kaiserShao/LEDPlay/灯带消消乐小程序头像 (1).jpg

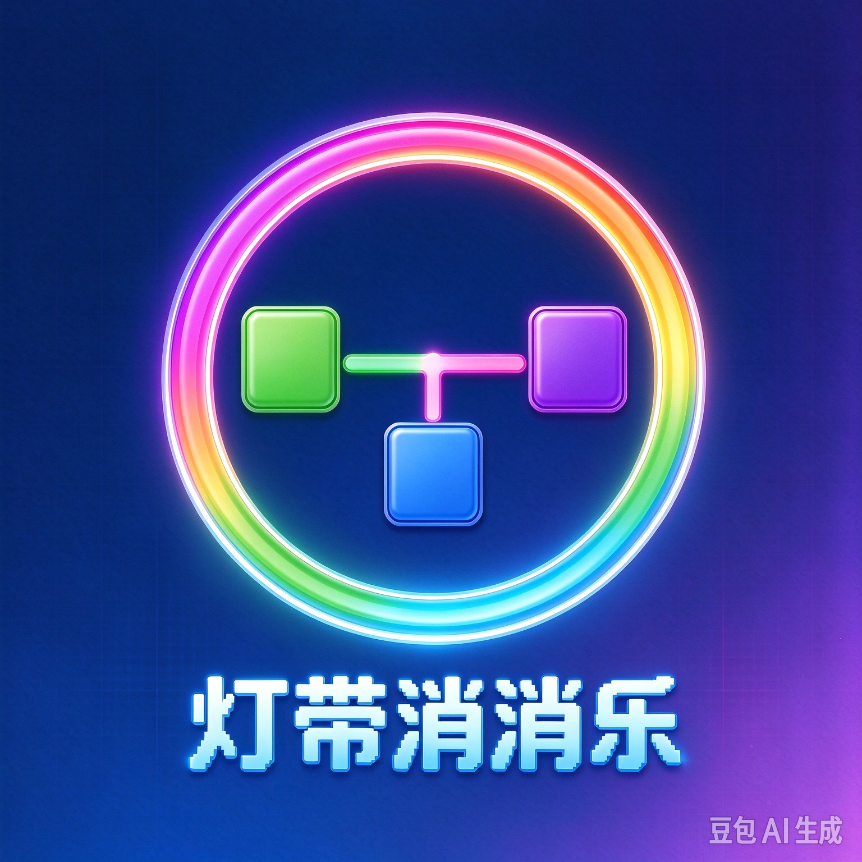
灯带消消乐小程序头像 (1).jpg
