kaiserShao/LEDPlay/Soft/Doc/WT2003_退役命令与自检备份.md

# WT2003 退役命令 / 自检 / 排查日志（备份文件）

> 精简固件时从代码里摘出来的东西，全部留档在这里。目的只有一个：
> 以后想找回某段逻辑、某个命令码、或某次排查的结论时，能在这里直接查到。
>
> 精简后的固件**只保留实测可用的这几条命令**（定义见 `Inc/bsp_config.h` 第 8 节、`Inc/drv_wt2003h.h`）：
>
> | 功能 | 命令码 | 帧（实测） | 接口 |
> |---|---|---|---|
> | 设置音量 | `AE` | `7E 04 AE <vol> <ck> EF` | `wt2003_set_volume(v)` |
> | 查询文件总数 | `C4` | `7E 03 C4 C7 EF` | `wt2003_query_count()` |
> | 按根目录索引播放 | `9D` | `7E 05 9D <高> <低> <ck> EF` | `wt2003_play_index(n)` |
> | 按文件名播放 | `9E` | `7E 07 9E <4 字符> <ck> EF` | `wt2003_play_name("0001")` |
> | 指定播放模式 | `AF` | `7E 04 AF <mode> <ck> EF` | `wt2003_set_mode(m)` |
> | 停止播放 | `AA` | `7E 03 AA AD EF` | `wt2003_stop()` |
> | **插播（叠加）** | `B1` | `7E 06 B1 <标示字> <高> <低> <ck> EF` | `wt2003_insert_index(n)` |
>
> 插播的**标示字**：`00` = FLASH（外挂 SPI Flash 片）/ `02` = U 盘（手册 4.1.2.14）；
> 例 外挂 Flash 曲目 3 → `7E 06 B1 00 00 03 BA EF`。
>
> 帧格式：`7E | 长度 | 命令 | 数据… | 校验码 | EF`，
> 长度 = `自身(1)+命令(1)+N(数据)+校验码(1)`，校验码 = 从"长度"字节起逐字节累加和。

## 1. 退役了什么（对照表）

| 退役项 | 原来在哪 | 留档位置（见文末对应标记段） |
|---|---|---|
| 38 步"语音链路体检"自检序列 + 探针回调 + 数码管显示步号 | `drv_wt2003h.c` / `main.c` | **D**、**E**、**C**；完整原件 `Doc/orig_20261005/` |
| Key 口 K1~K3（开漏低脉冲、语音编号→Key 绑定表） | `drv_wt2003h.c/.h` / `bsp_config.h` | **A**、**B**、**J** |
| 按文件名轮播（`A7`，每 4s 播下一个 + 自动查 C9/CB） | `drv_wt2003h.c` / `bsp_config.h` / `main.c` | **A**、**B**、**D**、**E** |
| 其它串口命令封装：`A0/A1/A6/A7/A8/AA/AB/AC/AD/AF/B0/B1/B6/B7/B8/D2/C0..CB` | `drv_wt2003h.c/.h` | **B**；完整原件 `Doc/orig_20261005/` |
| 主机调试命令：`WTRAW` / `WTPROBE` / `WTSTOP` / `WTST` / `VCHECK` / `VOUT` / `VQRY` / `VPLAY6` / `VPLAY0` / `VNAMEON` / `VNAMEOFF` / `VKEY` / `VSTOP` / `VPAUSE` / `VNEXT` / `VPREV` | `Src/app_cmd.c` / `Inc/app_cmd.h` | **F**、**G**、**K** |
| 收发帧的"人话解析"打印（`WTRXRAW/WTRX/WTRXINFO ...`） | `Src/main.c` | **D** |
| 旧 README 第 3.6 节 / 第 8 节（含 5 轮实测日志） | `README_DRIVERS.md` | **B** / **C** |
| 关机提示音（旧：`wt2003_talk(10)` 按编号播） | `Src/app_cmd.c` | **I** |
| 语音任务的"队列模式"（`wt2003_use_task/take_request/exec_request`） | `Src/app_task.c` / `drv_wt2003h.c` | **J** |

## 2. 旧驱动命令表（《WT2003H4-16S-A01》手册口径，**已废弃**）

> 这是精简前驱动里实现的整套命令（`drv_wt2003h.h` 的 `WT2003_CMD_xxx`）。
> 它们**不是**本模块真正吃的那套 —— 手头《WT2003HX》手册的可用命令见 `bsp_config.h` 第 8 节那 4 条。

| 命令 | 功能 | 数据 | 旧接口 |
|---|---|---|---|
| `A0` | 指定 **SPI Flash** 根目录索引播放 | 曲目号 2 字节（高/低） | `wt2003_play_flash(id)` |
| `A1` | 指定 **Flash** 按文件名播放 | 文件名 4 字节 ASCII | — |
| `A6` | 指定 **U 盘**根目录索引播放 | 曲目号 2 字节 | `wt2003_play_udisk(id)` |
| `A7` | 指定 **U 盘**按文件名播放 | 文件名 4 字节 ASCII | `wt2003_play_udisk_name("T002")` |
| `A8` | 指定 **U 盘文件夹内**文件索引播放 | 文件夹名 5 字节 + 索引 2 字节 | `wt2003_play_udisk_folder()` |
| `AA` | 播放 / 暂停 切换 | 无 | `wt2003_pause()` |
| `AB` | 停止 | 无 | `wt2003_stop()` |
| `AC` / `AD` | 下一曲 / 上一曲（跟当前盘符） | 无 | `wt2003_play_next/prev()` |
| `AE` | 音量控制 | 0~31 | `wt2003_set_volume(v)` |
| `AF` | 播放模式 | 00 单曲不循环 / 01 单曲 / 02 全部 / 03 随机 | `wt2003_set_mode(m)` |
| `B0` / `B1` | 组合播放 / 插播 | 标示字 + 索引（**`00`=FLASH（外挂 SPI Flash）** / `02`=U 盘，见现用手册 4.1.2.14） | `wt2003_play_combo()` / `wt2003_insert()` |
| `B6` | 音频输出方式 | 00 = SPK / 01 = DAC | `wt2003_set_output(o)` |
| `B7` | Flash 引脚加载 / 释放 | 00 释放 / 01 加载 | `wt2003_flash_pin(l)` |
| `B8` | 低功耗 | 1 字节 | `wt2003_low_power(m)` |
| `D2` | 切换当前工作盘符 | 00 = SPI-Flash / 02 = U 盘 | `wt2003_select_drive(d)` |
| `C0` | 查询软件版本 | 回 4 字节 | `wt2003_query_version()` |
| `C1` | 查询当前音量 | 回 1 字节 | `wt2003_query_volume()` |
| `C2` | 读取工作状态 | 回 1 字节：01 播放 / 02 停止 / 03 暂停 | `wt2003_query_status()` |
| `C3` | 查询 SPI Flash 文件总数 | 回 2 字节 | `wt2003_query_file_num()` |
| `C7` | 查询 U 盘文件总数 | 回 2 字节（实测只回 1 字节） | `wt2003_query_udisk_num()` |
| `C8` | 查询 U 盘指定文件夹内文件数 | 文件夹名 5 字节 → 回 2 字节 | `wt2003_query_ufolder_num()` |
| `C9` | 查询当前播放文件号 | 回 2 字节 | `wt2003_query_cur_file()` |
| `CA` | 查询外设连接状态 | 回 1 字节：bit3=PC / bit2=U 盘 / bit0=Flash | `wt2003_query_conn()` |
| `CB` | 查询当前歌曲名 | 回 8 字节 ASCII（实测只回 1 字节） | `wt2003_query_cur_name()` |

写命令返回码（旧手册）：`00` = OK / `01` = FAIL / `02` = EMP(无此文件)；
实测本模块对 `A6/D2/C7` 曾回手册未定义的 `0x05`，而且同一轮里喇叭确实出声 —— 所以**返回码不能当"有没有播"的判据**。

<!-- ===================== A : Doc/removed_bsp_sec8.txt ===================== -->

~~~~
<!-- ======== 涓嬮潰杩欐鏄粠 Inc\bsp_config.h 绗?234~336 琛岀Щ闄ょ殑鍘熸枃(鐣欐。) ======== -->
/*==============================================================================
 * 8. WT2003H4-16S 语音模块 (USART3: PB10=TX, PB11=RX ; K1~K3: PB0~PB2)
 *============================================================================*/
#define WT2003_UART                  USART3
#define WT2003_UART_CLK              RCC_APB1Periph_USART3
#define WT2003_UART_IRQn             USART3_IRQn
#define WT2003_TX_PORT               GPIOB
#define WT2003_TX_PIN                GPIO_Pin_10
#define WT2003_RX_PORT               GPIOB
#define WT2003_RX_PIN                GPIO_Pin_11
#define WT2003_BAUD                  9600U
#define WT2003_RX_BUF_SIZE           128U
#define WT2003_USE_CHECKSUM          1U       /* 1 = 帧尾前带累加和校验(WT2003HX 手册固定带),
                                                 0 = 不带 */
#define WT2003_LEN_COUNT_SELF        1U       /* 1 = 长度字节把[长度字节自己]也算进去
                                                 (WT2003HX 手册固定如此: 长度 = 1 + 命令 +
                                                 数据 + 校验码),
                                                 0 = 长度 = 命令 + 数据(+校验码) */
/* "按索引播放"走哪条命令 —— 只影响 wt2003_play_index()/wt2003_talk() 的串口通路:
    1 = A6 指定 U 盘根目录索引播放(《WT2003H4-16S-A01》手册 4.1.3.4;
        帧 7E 05 A6 <曲目高位> <曲目低位> <校验码> EF, 例 索引2 -> 7E 05 A6 00 02 AD EF);
    0 = A0 指定 SPI Flash 根目录索引播放(模块内置/外挂 SPI Flash 上的文件)。

    !!! 实测(模块固件 WTS251016-70-A01V4.01, 复现日志见 README 8.7 / 结论见 8.9):
        A0 索引 1        -> 回 02 = EMP(无此文件), 与本工程音频放在 U 盘相符;
        A6 索引 0/1/2/99 -> 一律回 0x05(手册未定义), 而且自检里 AC/AD(下一曲/上一曲)
                            真的出声、A6 一次都没出声 => 本模块的 A6 是"收下命令但不播"。
        => 要播指定语音请改走"按文件名播放"(A7):
           文件放 U 盘根目录、文件名固定 4 字符(如 T001.mp3 -> 数据 "T001"),
           驱动接口 wt2003_play_udisk_name("T001"), 配置见下面的 WT2003_NAME_CYCLE_*,
           串口命令 VNAME <n> / VNAMEON / VNAMEOFF。
    不想重烧就想两种都试: 串口发 VPLAY6 <idx>(A6) / VPLAY0 <idx>(A0) 对照听。 */
#define WT2003_PLAY_USE_UDISK        1U

/* Key 口(K1~K3)总开关:
   0 = 关闭(默认, 本项目的标准品 WT2003H4-16S 未开放 Key 口功能, 需芯片厂家定制):
         - wt2003_init() 不初始化 PB0~PB2, 也不建立"语音编号 1/2/3 -> K1/K2/K3"绑定;
         - wt2003_talk()/VOICE 一律走串口 A0 -> 绝不会出现"编号 1/2/3 静默无反应";
         - VKEY 直接回 ERR(提示已关闭)。
   1 = 打开(仅当模块已定制 Key 口功能时才用)。 */
#define WT2003_KEY_ENABLE            0U
#define WT2003_KEY_COUNT             3U       /* K1/K2/K3 */
#define WT2003_KEY_PORT              GPIOB
#define WT2003_KEY_GPIO_CLK          RCC_APB2Periph_GPIOB
#define WT2003_KEY1_PIN              GPIO_Pin_0
#define WT2003_KEY2_PIN              GPIO_Pin_1
#define WT2003_KEY3_PIN              GPIO_Pin_2
#define WT2003_KEY_PULSE_MS          100U     /* Key 口触发脉冲宽度 (拉低时间) */
#define WT2003_KEY_ROUTE_NUM         8U       /* ID -> Key 口 绑定表容量 */
#define WT2003_DEFAULT_VOLUME        31U      /* 上电默认音量 0~31 (手册: 上电默认最大 1F) */
#define WT2003_BOOT_VOICE            1U       /* 上电提示音编号(0 = 开机不播放) */
#define WT2003_BOOT_DELAY_MS         300U     /* 上电先等模块就绪(ms)再发首条命令 */
#define WT2003_PROBE_ON_BOOT         0U       /* 0 = 关闭(当前值): 上电不跑体检, 只按下面的
                                                 提示音/按文件名轮播播音频(见 8.1 节);
                                                 1 = 上电自动跑"语音链路体检"38 步
                                                 (AB 停止 -> D2 盘符=U 盘 -> B6 切 SPK ->
                                                  AE 音量 31 -> CA 查连接 / C7 查 U 盘文件数
                                                  (C3/C7 实测都只回 1 字节, 别拿来判介质) ->
                                                  C9/C2 基准 -> A6 播 U 盘索引 1 ->
                                                  AA 暂停后再 A6(判断"忙碌拒绝") ->
                                                  DAC/SPK 各播一次 -> AC/AD 换曲看 C9 ->
                                                  A6 播索引 2 扫 U 盘文件 -> AB 停止),
                                                 数码管显示步号, 日志见
                                                  WTTX/WTRX/WTRXINFO; 排查时置 1 即可;
                                                  实测结论(本模块 A6 收下命令但不出声、
                                                  AC/AD 才出声, 故改用 A7 按文件名播放)
                                                  见 README 8.9 */
#define WT2003_PROBE_INTERVAL_MS     1500U    /* 每步默认间隔(ms); 单步可用表里的 gap_ms 覆盖 */
#define WT2003_PROBE_ROUNDS          0U       /* 整个序列跑几轮(体检用 1 轮, 免得反复播) */

/*==============================================================================
 * 8.1 按文件名轮播(A7 播 U 盘根目录已知文件名) —— 排查"没声音"用, 也可当正式播放
 *     为什么用它: 实测本模块 A6(指定 U 盘索引播放)收到命令却不出声(回 0x05),
 *     而 A7 按文件名播放能出声(见 README 8.9)。
 *     前提: 音频文件放在 U 盘根目录, 且文件名**固定 4 个字符**(扩展名另算),
 *           例如 T001.mp3 / T002.mp3 ... -> 命令数据就是 "T001" / "T002"。
 *     开: WT2003_NAME_CYCLE_ON_BOOT = 1(上电立刻开始, 每 WT2003_NAME_CYCLE_MS 毫秒
 *         播下一个并循环; 串口打 "NAME n/N \"T00n\"", 数码管显示第几个)。
 *============================================================================*/
#define WT2003_NAME_CYCLE_ON_BOOT    1U       /* 1 = 上电开始按文件名轮播(当前排查用);
                                                 0 = 关闭(正式模式交给业务层点播) */
#define WT2003_NAME_CYCLE_MS         4000U    /* 每个文件播放/间隔时间(ms)。不要小于单个
                                                 音频时长, 否则下一首会把上一首切掉 */
#define WT2003_NAME_CYCLE_QUERY_MS   800U     /* 播后多少毫秒自动查一次 C9(当前曲目号) +
                                                 CB(当前曲目名), 用来确认"到底播没播";
                                                 必须 < WT2003_NAME_CYCLE_MS */
/* 要轮播的 4 字符文件名列表(按 U 盘里的真实名字改; 个数不限, 至少 1 个) */
#define WT2003_NAME_CYCLE_LIST        { "T001", "T002", "T003", "T004", "T005" }
#define WT2003_TX_TIMEOUT_MS         50U      /* 串口发送超时保护 */
#define WT2003_RX_FRAME_MAX          32U      /* 接收帧最大长度(实测 C0 版本查询的回帧较长,
                                                  16 字节不够会被整帧丢弃, 见 README 8.4) */
#define WT2003_RX_TRACE              1U       /* 0 = 关闭(默认, 正式模式静默, 不占串口带宽);
                                                 1 = 把模块返回帧实时打印到 ESP32 串口
                                                 (形如 "WTRX A0 00", 排查用; 判读见 README 第 8 节) */
#define WT2003_TX_TRACE              1U       /* 0 = 关闭(默认, 正式模式静默);
                                                 1 = 把主机"真正发出去"的每一帧原样打印到
                                                 ESP32 串口, 形如:
                                                     WTTX 7E 05 A6 00 01 AC EF   (发给模块: A6 播 U 盘索引 1)
                                                     WTRXRAW 7E 04 A6 00 AA EF   (模块回帧, 原始字节, 形如)
                                                 注: 按索引播放默认走 A6(播 U 盘, 见 WT2003_PLAY_USE_UDISK);
                                                     若选 A0(播 SPI Flash)则首帧是 7E 05 A0 00 01 A6 EF。
                                                 排查"到底发了几个字节/模块回什么"用, 不用挂
                                                 调试器也不用量逻辑分析仪; 排查时置 1 即可 */

~~~~

<!-- ===================== B : Doc/removed_readme_sec36.md ===================== -->

~~~~
<!-- ======== 涓嬮潰杩欐鏄粠 README_DRIVERS.md 绗?318~470 琛岀Щ闄ょ殑鍘熸枃(鐣欐。) ======== -->
### 3.6 语音模块 WT2003H4-16S（`drv_wt2003h`）—— Key 口与串口合并成一个方法
业务层只需要记一个入口：

```c
wt2003_talk(voice_id);        /* 自动选路: 查绑定表 → 命中走 Key 口(最快), 否则走串口 */
```

* 绑定关系：`wt2003_bind_key(voice_id, key_idx)`（0/1/2 → K1/K2/K3，`0xFF` 解除）。
  **默认关闭 Key 口**（`WT2003_KEY_ENABLE = 0`）：本项目的标准品 WT2003H4-16S 未开放
  Key 口功能（需芯片厂家定制），所以上电不再建立"1/2/3 → K1/K2/K3"绑定，
  `wt2003_talk()` 一律走串口 `A0`，不会出现"编号 1/2/3 静默无反应"；
  `VKEY` 也会直接回 `ERR VKEY unavailable`。改用定制模块时把该宏置 1 即可恢复原行为
  （宏位 1 时上电默认：编号 1/2/3 分别走 K1/K2/K3）。
* 想强制某条通路：`wt2003_talk_src(id, WT2003_SRC_UART)` 或 `WT2003_SRC_KEY`
  （Key 口关闭时 `SRC_KEY` 会自动退回 `SRC_UART`，保证"要播就能播"）。
* **串口协议（已对齐《WT2003HX 芯片》手册）**：

  帧格式：`7E | 长度 | 命令 | 数据… | 校验码 | EF`
  * 长度 = `1(长度字节自身) + 1(命令) + N(数据) + 1(校验码)`（**含自己**）；
  * 校验码 = 从"长度"字节起逐字节累加和（mod 256）。

  例（手册原例，本驱动发出的帧与之一致）：
  ```
  A0 SPI Flash 索引 1 :  7E 05 A0 00 01 A6 EF   (05+A0+00+01 = A6)
  A6 U 盘 索引 2      :  7E 05 A6 00 02 AD EF   (05+A6+00+02 = AD)
  AE 音量 = 31        :  7E 04 AE 1F D1 EF      (04+AE+1F     = D1)
  ```

  > ⚠ **介质决定命令码**：`A0` 只播 **SPI Flash** 上的文件，`A6` 只播 **U 盘**上的文件（手册 4.1.3.4）。
  > 命令用错时模块会回**非 0**（"指定曲目不存在"）而**不出声** —— 实测现象就是"命令回了、索引也在、就是没声音"。
  > 本项目音频放在 **U 盘**上，所以走 `A6`（`bsp_config.h` 的 `WT2003_PLAY_USE_UDISK = 1`）。

  命令码（`drv_wt2003h.h` 的 `WT2003_CMD_*`）：

  | 码 | 功能 | 数据 | 封装函数 |
  |---|---|---|---|
  | `A0` | 指定 **SPI Flash** 根目录索引播放 | 曲目号 2 字节(高/低) | `wt2003_play_flash(id)` |
  | `A1` | 指定 **Flash** 按文件名播放 | 文件名 4 字节 ASCII | —（手册 4.1.3.3） |
  | `A6` | 指定 **U 盘**根目录索引播放 | 曲目号 2 字节(高/低) | `wt2003_play_udisk(id)` |
  | `A7` | 指定 **U 盘**按文件名播放 | 文件名 4 字节 ASCII | `wt2003_play_udisk_name("T002")` |
  | `A8` | 指定 **U 盘文件夹内**文件索引播放 | 文件夹名 5 字节 + 索引 2 字节 | `wt2003_play_udisk_folder("MUSIC", n)` |
  | `AA` | 播放暂停（播放 <-> 暂停 切换） | 无 | `wt2003_pause()` |
  | `AB` | 停止 | 无 | `wt2003_stop()` |
  | `AC` | 下一曲（跟当前工作盘符） | 无 | `wt2003_play_next()` |
  | `AD` | 上一曲（跟当前工作盘符） | 无 | `wt2003_play_prev()` |
  | `AE` | 音量控制 | 0~31 | `wt2003_set_volume(v)` |
  | `AF` | 指定播放模式 | `00` 单曲不循环 / `01` 单曲循环 / `02` 全部循环 / `03` 随机 | `wt2003_set_mode(m)` |
  | `B1` | 插播 | 标示字（**`00`=FLASH（外挂 SPI Flash）** / `02`=U 盘，手册 4.1.2.14）+ 索引 2 字节 | `wt2003_insert(buf, len)` |
  | `B6` | 音频输出方式 | `00`=SPK / `01`=DAC（手册示例：**无返回码**） | `wt2003_set_output(...)` |
  | `B7` | Flash 引脚加载 / 释放 | `00`=释放 / `01`=加载 | `wt2003_flash_pin(load)` |
  | `D2` | 切换当前工作盘符 | `00`=SPI-Flash / `02`=U 盘 | `wt2003_select_drive(WT2003_DRIVE_UDISK)` |
  | `C0` | 查询软件版本（手册未列出，实测有应答） | — | `wt2003_query_version()` |
  | `C1` | 查询当前设置音量 | — | `wt2003_query_volume()` |
  | `C2` | 读取当前工作状态（`01` 播放 / `02` 停止 / `03` 暂停） | — | `wt2003_query_status()` |
  | `C3` | 查询 **SPI-Flash** 内音乐文件总数 | — | `wt2003_query_file_num()` |
  | `C7` | 查询 **U 盘**内音乐文件总数 ← **本项目用这条** | — | `wt2003_query_udisk_num()` |
  | `C8` | 查询 U 盘指定文件夹内文件总数（回 `00 00` = 无此文件夹） | 文件夹名 5 字节 | `wt2003_query_ufolder_num("MUSIC")` |
  | `C9` | 查询当前播放文件曲目 | — | `wt2003_query_cur_file()` |
  | `CA` | 查询当前外设连接状态（bit3=PC / bit2=U 盘 / bit0=SPI-Flash，1=存在） | — | `wt2003_query_conn()` |
  | `CB` | 查询当前播放歌曲名（8 字节 ASCII，不足补 `20`） | — | `wt2003_query_cur_name()` |
  | `B0` / `B8` | 组合播放 / 低功耗（本版手册未列出，保留兼容） | — | `wt2003_play_combo` / `wt2003_low_power` |

  > **介质千万别搞错**：`A0/A1` 与 `C3` 是 **SPI-Flash**；`A6/A7/A8` 与 `C7/C8` 是 **U 盘**。
  > 本项目音频在 U 盘 → 播放用 `A6`（或 `A7/A8`），"还有几个文件"看 `C7`，
  > "模块认到盘没有"看 `CA` 的 bit2；`C3` 恒为 0 属正常（它查的是 SPI-Flash）。

  > **写命令的返回码**（手册 4.1.3.1"写操作指令返回码格式"）：执行完每条写命令，模块回
  > `<命令码> <1 字节操作码>`：`00 = OK` / `01 = FAIL（出错，不执行）` / `02 = EMP（无此文件）`。
  > ★ 但本模块（`WT2003H4-16S`，固件 `WTS251016-70-A01V4.01`）实测 `D2` / `A6` / `C7`
  > 都回 **`0x05`** —— 手册里没有这个值，而同一轮音频**照样播出来了**：
  > 所以 **`0x05` 绝不能当"没播"**，`A6`/`D2` 回非 0 不等于失败，`README 8.7` 有完整判读。
  > 查询命令（`C1/C2/C3/C7/C8/C9/CA/CB`）回的是**数据**、不是返回码，别套这张表。

  > 音量共 **32 级（0~31）**：0 = 静音、31 = 最大；此命令**掉电记忆**，模块上电默认最大（`1F`）。
  > 查询命令只发帧，应答由 `wt2003_set_frame_handler()` 回调上报（远程命令 `VQRY` 可触发，见第 4 节）。
  > **按索引播放**的封装函数 `wt2003_play_index(id)` = `wt2003_talk()` 走串口那条路，它用哪条命令
  > （`A6` 播 U 盘 / `A0` 播 SPI Flash）由 `bsp_config.h` 的 `WT2003_PLAY_USE_UDISK` 选（默认 `1` = `A6`）。
  > **⚠ 但本模块实测 `A6` 收下命令却不出声（第五轮定论，见 8.9）**：要播指定语音请改走
  > `A7` 按文件名播放 —— `wt2003_play_udisk_name("T001")` / 远程 `VNAME <n>`（文件名 4 字符、放 U 盘根目录）。

* **按文件名轮播（`WT2003_NAME_CYCLE_ON_BOOT`，当前为 **1** = 开）**：上电用 `A7` 每
  `WT2003_NAME_CYCLE_MS`（`4000` ms = **4 秒**）播 `WT2003_NAME_CYCLE_LIST` 里的下一个文件名并循环，
  播后自动查一次 `C9`/`CB`（确认模块到底播的是哪一首）；数码管显示第几个，串口打 `NAME n/N "T00n"`。
  **这是本模块唯一能播指定语音的路**（`A6` 无效，见 8.9）；不用时置回 `0`。
  远程命令：`VNAME`（列名字表）/ `VNAME <n>`（立刻播第 n 个）/ `VNAMEON` / `VNAMEOFF`。
* **语音链路自检序列（`WT2003_PROBE_ON_BOOT`，当前为 **0** = 关闭 —— 第五轮结论已拿到（见 8.9），
  正式模式走"按文件名轮播"或开机提示音 `WT2003_BOOT_VOICE`；要复现时再置 1）**：置 1 时上电后按
  各步自己的间隔自动走完 **38 步**，**数码管显示第几步**（`0001`~`0038`），
  同时从 ESP32 串口打一行 `PROBE n/38 <说明> rx=..`；结束时数码管显示模块**回帧计数**低 4 位
  （`0000` = 模块一句都没回），串口还会打一行 `PROBE DONE rx=.. cmd=..`。
  也可随时用远程命令 `WTPROBE n` 单独发第 n 步、`WTSTOP` 停止、`WTST` 看状态。
  排查完把 `WT2003_PROBE_ON_BOOT` 改回 **0**（仓库默认就是 0；正式模式只播开机提示音）。

  | 步骤 | 实际发出的东西 | 说明 |
  |---|---|---|
  | 1 | `AB` | 停止播放，清掉"卡在播放/忙"的状态 |
  | 2 | `D2 02` | 切换当前工作盘符 = **U 盘**（让 `AC/AD`、循环这些"跟着当前盘走"的命令也作用在 U 盘） |
  | 3 | `B6 00` | 输出 = `SPK`（**喇叭必须接 `SPK+` 与 `SPK-` 两端**，一端接 GND 则永远无声） |
  | 4 | `AE 1F` | 音量 = 31（排除"音量被存成 0 = 静音"） |
  | 5~7 | `C1` / `CA` / `C7` | 播放前基准：音量 / **外设连接（`UDISK` 位必须是 1）** / **U 盘文件数（`00 00` = 模块看不到文件）** |
  | 8~9 | `C9` / `C2` | 当前文件号 / 工作状态基准（打印后面带 `UNCHANGED` / `CHANGED!`） |
  | 10 | `A6 00 01`（U 盘索引 1） | 第 1 次试播 —— **听**有没有声 |
  | 11~12 | `C9` / `C2` | 当前文件号 / 状态**有没有跟着变** |
  | 13~14 | `AA` / `C2` | 把"自认为在播"的东西**暂停掉**，再看状态 |
  | 15 | `A6 00 01` 再来一次 | 和无声音时的旧结论对比：**只有回 `00` 才算"忙碌拒绝"**；本固件 `A6` 回 `05` 时照样出声（见 8.7）—— **听** |
  | 16~17 | `C9` / `C2` | |
  | 18 | `AB` 停止 | |
  | 19~20 | `B6 01` → `A6 00 01` | 换到 `DAC` 通路再试播（喇叭若实际走 DAC / 功放，这一步后有声）—— **听** |
  | 21~22 | `AA` → `B6 00` | 切回 `SPK` 通路 |
  | 23~24 | `A6 00 01` / `C2` | 在 `SPK` 通路再试播 —— **听** |
  | 25~28 | `AC` + `C9`、`AD` + `C9` | 换曲引擎：`cur_file` 会不会在 1 与 2 之间跳 |
  | 29 | `A6 00 02` | 扫 U 盘文件索引 2（回 `00` = 该索引有文件可播，`02` = 无此索引）—— **听** |
  | 30 | `AB` 停止 | 收尾 |
  | 31 | `C3` | 文件数查询 —— 手册写它是 **SPI-Flash** 口径，但**实测本模块 `C3 == C7` 同为 1 字节（都回 `05`）**，所以它**不能**用来判介质（判介质见 8.9） |
  | 32 | `A6 00 63` | 发一个**必定不存在**的索引（99）：应回 `02 = EMP（无此文件）`——用它验证"返回码表在不在本固件生效" |
  | 33 | `C2` | 那条"失败"的 `A6` 有没有影响状态 |
  | 34 | `A6 00 00` | 索引 **0**：有些固件的索引从 0 开始（手册 4.1.4.5 示例写"索引 `0001` = 第 2 首"）—— **听** |
  | 35 | `C2` | 短间隔再查一次：有没有变成 `01 = 播放` |
  | 36 | `A0 00 01` | SPI-Flash 口径播索引 1（Flash 里真没文件时应回 `02`，交叉验证 31） |
  | 37 | `C9` | 当前文件号 |
  | 38 | `C2` | 收尾状态 |

  > 实测例（第四轮，2026-07，38 步序列，完整日志与判读见 **8.7**）：`D2 → 05`、`B6 → 00`、`AE → 00`、
  > `C1 = 1F`（音量满）、`CA = 00`（`UDISK` 位 = 0，可 `C7` 却回 `05` = 5 个文件）、
  > `C9 = 0001 → 0002 → 0001`（`AC`/`AD` 真的把当前曲目推动了）、`C2 = 02`（全程 `STOPPED`）、
  > `A6` 试播回 `0x05` —— **现场反馈这几步里喇叭确实出声了**。
  > ⇒ 本固件的 `0x05` **不是"失败"**（手册 4.1.3.1 只定义了 `00 / 01 / 02`），
  > 判断"到底播没播"必须**以耳朵为准**，不能只看返回码。
  > 更早的实测例（8.4~8.6，旧序列）：`C3 = 05`、`C9 = 0001`、`C2 = 02`、`A0` 索引 0 回 `01`、
  > 索引 1~4 回 `02`、`C0 = WTS251016-70-A01V4.01`，全程无声。

  > → "忙"和"没文件"都被排除，嫌疑落在「模块播不了这些文件（格式 / 文件系统）」或「曲目索引没建立」，
  > 靠第 15 / 17 步（`AA` / `AC`，绕过索引）来区分。
  > Key 口：本项目标准品 WT2003H4-16S 没开放 Key 口功能（需厂家定制，`WT2003_KEY_ENABLE = 0`），
  > 自检序列里的 Key 步骤已移除（`VKEY` 会直接回 `ERR VKEY unavailable`）；换成定制模块后
  > 用 `VKEY 0/1/2` 单独触发即可。
  > 索引：`A0`/`A6` 的曲目号是 2 字节（高/低），模块内文件索引通常按扫描顺序，不一定等于文件名数字。
  > 介质：本项目用 **U 盘**（`A6`，`WT2003_PLAY_USE_UDISK = 1`）；用错命令（拿 `A0` 播 U 盘）会回非 0 且不出声。
* Key 口：开漏输出 + 低脉冲（脉宽 = `WT2003_KEY_PULSE_MS`，由 `wt2003_process()` 到点释放，**不阻塞业务**）。
* 其他串口命令：`wt2003_play_index / play_next / play_prev / pause / stop / set_volume /
  set_mode / play_combo / insert / set_output / low_power / query_*`，
  也可用 `wt2003_send_cmd(cmd, data, len)` 或 `wt2003_send_raw(frame, len)` 发手册上的任意帧。
* 模块返回帧由 `wt2003_process()` 解析，结果通过 `wt2003_set_frame_handler()` 回调上报
  （驱动已剥掉命令码与校验码，回调拿到的是纯数据区）。

**⚠ 与实物核对清单（都集中在 `bsp_config.h` / `drv_wt2003h.h`）：**

1. **命令码**：`WT2003_CMD_*`（已按 WT2003HX 手册填好：`A0/A6/AA/AB/AC/AD/AE/…`）；固件不同时只改这一处。
   **按索引播放用哪条命令**由 `bsp_config.h` 的 `WT2003_PLAY_USE_UDISK` 决定（**U 盘 = `A6`**：置 `1`；SPI Flash = `A0`：置 `0`）。
2. **帧格式**：`WT2003_USE_CHECKSUM = 1`、`WT2003_LEN_COUNT_SELF = 1`（手册固定如此，勿改）。
3. **波特率**：`WT2003_BAUD`（取值见 `bsp_config.h` 第 8 节）。
4. **音频输出方式**：喇叭接模块内部功放（SPK）却无声时，用 `VOUT 0` 或上电发一次 `B6 00` 切回 SPK。

~~~~

<!-- ===================== C : Doc/removed_readme_sec8.md ===================== -->

~~~~
<!-- ======== 涓嬮潰杩欐鏄粠 README_DRIVERS.md 绗?765~1185 琛岀Щ闄ょ殑鍘熸枃(鐣欐。) ======== -->
## 8. WT2003 语音排查（协议已按手册对齐）

> **⚠ 先看这两条（第五轮定论，完整判读见 8.9）**：
> 1. `A0`（SPI Flash 索引）会被模块当"指定曲目不存在"拒绝（回 `02`）—— 本工程音频在 **U 盘**上，
>    用 `A0` 自然全程无声；8.4~8.6 里"模块播不了文件 / 曲目索引没建立"的结论是**在命令用错的前提下**得到的。
> 2. **但 `A6`（指定 U 盘根目录索引播放）在本模块上也不出声**：它收下命令、回一个固定字节 `05`，
>    却从不播放（索引 1 / 2 / 99 / 0 全试过，`cur_file` 从不因它变化）；而 `AC` / `AD`（下一曲 / 上一曲）
>    从停止态都能出声 ⇒ 播放引擎与音频链路正常，**只有"按索引指定曲目"这条路不通**。
>    ⇒ 正式播指定语音改用 **`A7` 按文件名播放**（文件名固定 4 字符、放 U 盘根目录）：
>    `wt2003_play_udisk_name("T001")` / 远程 `VNAME <n>`，配置与判读见 8.9.2。
> 现场对照：`VNAME 1` 应有声；`VPLAY6 1`（A6）/ `VPLAY0 1`（A0）都不出声。

### 8.1 看收发帧（`WT2003_TX_TRACE` / `WT2003_RX_TRACE`，仓库默认都是 0 = 关闭）
`Inc/bsp_config.h` 里这两个开关打开时，`main.c` 会把**每一次收/发**都从
**ESP32 串口（USART1, 115200）** 打一行 ASCII：

```
WTTX 7E 05 A0 00 01 A6 EF    主机真正发出去的原始字节(每次发帧都打)
WTRXRAW 7E 04 A0 00 A4 EF    模块回帧的原始字节(含 7E/长度/校验码/EF)
WTRX A0 00                   同一帧解析后的结果: 命令码 + 数据区
WTRX C1 1F                   命令码 0xC1(查询音量), 数据区 1F(=音量 31)
WTRXINFO A0(SPI-Flash) ret=0x02 = EMP (no such file)        解析成人话(见 8.4 / 8.7)
WTRXINFO A6(U-disk) ret=0x05 = 0x05 (undocumented; ... audio still plays)   ★ 非 0 ≠ 没播!
WTRXINFO flash_files=5 (SPI-Flash, 1-byte reply; compare with C7)  C3 的解析(实测只回 1 字节)
WTRXINFO udisk_files=5 (U-disk, 1-byte reply) [ok: ...]      C7 的解析 <== 本工程看这条
WTRXINFO conn=0x00 PC=0 UDISK=0 FLASH=0                      CA 的解析(要连 C7 一起看)
WTRXINFO cur_file=1 / volume=31 / status=0x02 [STOPPED]      C9 / C1 / C2 的解析
WTRXINFO ver=........ (len=26, hex 见上面的 WTRX 行)          C0 的解析(长回帧, 见 8.4)
WTRXBAD 7E 1A C0 ...         结构不对的回帧(帧尾不是 EF / 帧长超缓冲)也原样打出来
```

* **判据 0（先看有没有 WTRXBAD）**：`WTRXBAD` 行 = 模块回的字节**没能按手册格式解析**，
  例如长度字节口径不同、或整帧比 `WT2003_RX_FRAME_MAX` 还长。以前这类字节会被驱动**静默丢掉**，
  表现为"`WTST` 的 `rx=` 一直在涨，却一行 `WTRXRAW` 都没有"——看到 `WTRXBAD` 就以它为准。

* **判据 1（长度字节）**：手册 5.1.2.2 的原例是
  `发→ 7E 05 A0 00 01 A6 EF` / `收← 7E 04 A0 00 A4 EF`。
  主机发 `A0` **必然带 2 字节曲目号**（长度 05 = 1 自身 + 1 命令 + 2 数据 + 1 校验码）；
  模块回帧的长度只有 **04**（1 个数据字节）。所以看到 `7E 04 A0 xx ...` 是**模块的回帧**，
  不要当成主机发出去的帧。
* **判据 2（看谁在写缓冲）**：调试器里的 `s_rx_buf` 是驱动的**接收**环形缓冲
  （`drv_wt2003h.c`，`WT2003_RX_BUF_SIZE` = 128 字节；ESP32 的那个才是 512 字节），
  它是"模块 → MCU"的字节，还带上一帧的残留。想要"这一帧的干净原貌"用
  `wt2003_last_rx_raw(&len)`（`WTRXRAW` 行就是它），想要"主机发了什么"看 `WTTX` 行。
* 驱动按手册格式 `7E 长度 命令 数据 校验码 EF` 解析，`WTRX` **已剥掉命令码与校验码**，
  打印的就是纯数据区。
* 没有输出 = 模块没有回话，这就是最直接的判据；也可以用远程命令 `WTST` 看累计 `rx=` 字节数。
* 关闭：把两个开关都改成 0（**仓库默认就是 0**，正式固件免得占串口带宽；置 1 才有下面这些行）。

> 想确认"A6 到底发了几个字节"：把 `WT2003_TX_TRACE` 置 1 重烧，敲 `WTRAW 7E05A60001ACEF`
> 或跑 `WTPROBE 8`（自检表第 8 步 = `A6` 播 U 盘索引 1），串口应打出
> `WTTX 7E 05 A6 00 01 AC EF` —— 7 字节、长度 05。

### 8.2 由现象定位（按顺序做）

| 现象 | 结论 / 下一步 |
|---|---|
| `WTST` 的 `rx=0`（模块一句都没回） | 查 TX 线（PB10 → 模块 RXD）、**共地**、`WT2003_BAUD` = 9600、模块是否处于串口控制模式 |
| `rx` 在涨但没有 `WTRXRAW`，只有 `WTRXBAD` | 模块回帧**格式与手册不一致**（长度字节口径 / 帧长超 `WT2003_RX_FRAME_MAX`）→ 按 `WTRXBAD` 的原始字节对着手册核，别怀疑接线 |
| 自检第 1 步（`AB` 停止）之后、第 8 步（`A6`）之后才出声 | 模块此前卡在"播放/忙"（查询 `C2` = `02`）→ 正式固件上电应先 `VSTOP` 再播提示音 |
| 第 2 步（`B6 01` DAC）无声、第 3 步（`B6 00` SPK）才出声 | 模块此前处于 DAC 输出 → 用 `VOUT 0` 固定为 SPK，或核对喇叭接法 |
| `A6` 全回 `05` 且**全程无声**，但 **`AC` / `AD`（下一曲 / 上一曲）出声** | **第五轮定论（见 8.9）**：本模块 `A6` 收下命令但不播 → 改用 `A7` 按文件名播放（`VNAME <n>` / `wt2003_play_udisk_name("T001")`），不必再去折腾索引排序或厂商上位机 |
| `A6` 回 `01`（索引 0）、`A6` 回 `02`（索引 1~5）都没声，`AA`/`AC` 也没声 | 模块**播放不了它里面的文件**（不是索引问题）：文件格式/采样率/码率不被支持、或文件系统被半途拔线写坏 → 用厂商上位机＋标准 MP3 重灌（见 8.4） |
| `A6` 回 `00`（`ret=0x00`）但仍无声 | 播放已被接受 → 完全转音频侧：音量（`C1`）、输出方式（`B6` = SPK）、功放供电/使能脚、喇叭是否接在 `SPK` 13/14 脚、共地 |
| 查询回来 `files=0`（`C3` 回 `00`） | 模块**没认到文件**：格式 / 命名 / 目录不符合模块要求，用厂商上位机重新灌 |
| `WTRX A6 05`（或 `D2 05`） | 手册 4.1.3.1 只定义 `00/01/02`，`05` 是本固件私有的固定应答，**既不代表成功也不代表失败**；但第五轮实测 `A6` 回 `05` 时**确实一声都没有**（见 8.9）→ 别再用 `A6`，改 `VNAME <n>`（`A7`） |
| `WTRX A6 xx` 且 `xx` = `01` / `02` | 手册口径的**真失败**（`01` = 出错不执行 / `02` = 无此文件）：`VSTOP` → `VCHECK`（文件数 / 音量 / 当前文件）→ `VPLAY 1/5…` 扫索引，详见 8.4 |
| 索引对不上 | `VQRY FILES` / `VCHECK` 看文件总数（`udisk_files=`）、`C9` 看当前文件；**播指定语音用 `VNAME <n>`**（`A7` 按文件名，不受索引顺序影响），别用 `A6`（见 8.9） |

> `WTRX C1 xx` 的 `xx` 就是模块当前音量；`WTRX C2 xx` 是工作状态（实测 `02`）；
> `WTRX C3 xx` 是文件总数 —— **实测模块只回 1 字节**（`7E 04 C3 05 CC EF` = 5 个文件），
> 驱动对 1 字节和 2 字节两种回法都做了兼容解析。

### 8.3 免重烧试任意帧（`WTRAW`）
`wt2003_send_raw()` 挂在远程命令上，**不改代码、不重烧**就能把手册里的任意帧发给模块：

```
WTRAW 7E05A60001ACEF          # A6 播 U 盘索引 1（本工程音频在 U 盘）
WTRAW 7E 05 A6 00 01 AC EF    # 空格分隔；也接受 0x7E / 逗号 / 冒号
WTRAW 7E05A00001A6EF          # A0 播 SPI Flash 索引 1（对照用）
WTRAW 7E04AE1FD1EF            # AE 音量 = 31
WTRAW 7E04B600BAEF            # B6 切 SPK
```

* 应答 `OK WTRAW 7E05A00001A6EF (7 bytes)` = 已发出；`ERR WTRAW HEX ...` = 十六进制没解析出来；
* 模块回帧打印成 `WTRX ...`；`WTST` 可看 `rx=` / `cmd=` 计数。

### 8.4 实测案例：日志全对、有回帧，但一点声音都没有

现场日志（ESP32 串口 115200，`WT2003_TX_TRACE` / `WT2003_RX_TRACE` = 1）：

```
READY LEDAnipop fw=1.0 led=120
WTTX 7E 04 AE 1F D1 EF        ① 上电设音量 31（手册 5.1.2.7 原例, 4 字节）
WTTX 7E 05 A0 00 01 A6 EF     ② 上电播索引 1（手册 5.1.2.2 原例, 7 字节, 长度 05）
WTRXRAW 7E 04 AE 00 B2 EF     ③ AE 回帧: 长度 04, 数据 00
WTRXRAW 7E 04 A0 02 A6 EF     ④ A0 回帧: 长度 04, **数据 02**
WTRX A0 02
WTRXINFO A0 ret=0x02 (NOT started: send AB first, then check file/index)
```

再敲一次 `VCHECK`（把 C0/C1/C2/C3/C9 全查一遍），现场回帧：

```
WTTX 7E 03 C1 C4 EF
WTTX 7E 03 C2 C5 EF
WTTX 7E 03 C3 C6 EF
WTTX 7E 03 C9 CC EF
WTRXRAW 7E 04 C1 1F E4 EF      C1 回帧: 数据 1F = **音量已经是 31（最大）**
WTRXINFO volume=31 (0=silent, 31=max)
WTRXRAW 7E 04 C2 02 C8 EF      C2 回帧: 数据 02 = **不是空闲状态**
WTRXINFO status=0x02 (non-idle; 0x02 seen while A0 also replies 02)
WTRXRAW 7E 04 C3 05 CC EF      C3 回帧: 长度 04 → **只有 1 个数据字节**，05 = **模块认到 5 个文件**
WTRXINFO files=5 (1-byte reply; 0 = module sees no files)
WTRXRAW 7E 05 C9 00 01 CF EF   C9 回帧: 长度 05（2 字节数据）0001 = 当前文件 1
WTRXINFO cur_file=1
```

判读（这套日志已经能排除一半的怀疑方向）：

* ①② 证明**主机发送侧完全正确**：`A0` 就是 2 字节索引、长度 05，与手册逐字节一致；
  而且模块每次都有回帧，说明波特率 / 接线 / 共地也没问题。
* ③④ 是**模块的回帧**（长度 04，不是主机帧；主机帧长度必然是 05）。
* ④ 的数据字节是模块的**处理结果**：手册示例里这里是 `00`，实测是 `02`
  → **模块没有真正开始播放**，"没声音"的原因在模块侧（文件 / 索引），不在 MCU 侧。
* ③ `AE` 的回帧数据是 `00`，表示音量命令被接受（返回值口径见手册 5.1.2.7）。
  **它不等于当前音量** —— 想知道真实音量必须用 `C1` 查询（`VCHECK` 会打 `volume=`）：
  音量是**掉电记忆**的，若模块存的是 0（静音），播放"成功"也一样听不见。
* 文件是**用 USB 把模块当 U 盘拷进去**的（模块里确实有音频）→ 那么 `A0` 回 `02` 基本只剩
  **文件规则 / 索引号**问题：模块内的索引顺序由它扫描文件系统的顺序决定，**不一定等于文件名里的数字**。
  用 `VCHECK` 看 `files=`（模块认到几个文件），再用 `VPLAY 0/1/2…` 找到回 `ret=0x00` 的那个索引；
  若 `files=0`，则是文件**格式 / 命名 / 目录**不被模块认（对照手册的命名与格式要求重灌）。

`VCHECK` 之后方向就基本唯一了：

* 音量 = `1F`（31，最大）、文件数 = `05` → **"静音"和"没文件"这两个最常见的怀疑都被排除**。
* `C2`（状态）回的 `02` 与 `A0` 被拒时回的 `02` 是**同一个值** → 当时推测模块**一直认为自己"忙于
  播放/未就绪"**（例如上一次播放被中途打断后没清理），于是对任何新的 `A0` 都回 `02`。
  这种状态下继续扫索引没有意义，必须**先发 `AB` 停止清状态**再发 `A0`。
* 自检序列已按这个顺序改成（上电自动跑）：
  **1 = `AB` 停止 → 2~3 = `B6` 切 SPK → 4 = `AE` 音量 31 → 5~9 = `C1/C3/C9/C0/C2` 查询 →
  10~14 = 播放索引 0~4**；哪一步出声、哪一条回 `ret=0x00`，看日志就能定位。
  > 最终定位：本节及 8.5/8.6 里的 `A0` 是被"命令码用错"拖累的（`A0` 只播 SPI Flash）；本项目音频在 U 盘，
  > 现自检里的试播已全部改为 **`A6`（播 U 盘）**，见第 3.6 节。
  > 这一版跑完后（见 8.5）发现 `AB` 其实**回 `00` 被接受了**、而 `A0` 依旧全被拒，
  > 所以"忙于播放"被排除，序列随即改成 **20 步**（去掉 `C0` 的位置、加上 `AA`/`AC` 绕过索引）；
  > 20 步跑完的现场数据与判读见 **8.6**，序列再升级为 **30 步**；第四轮又加了
  > "返回码取证"（`C3` 对比、不存在的索引、索引 0、`A0`）成为 **38 步**，见 8.7。
* 如果 `AB` 之后 `A0` 仍回 `02`，则是**模块里的"曲目索引"没建立**：`C3` 只是数了文件系统里的文件，
  不代表模块已经把它们排好成"曲目 1/2/3…"。处理办法（按代价从小到大）：
  1. 用厂商上位机把这个 U 盘/模块里的音频**重新排序（生成/更新曲目索引）**；
  2. 或按手册要求把文件重命名（如 `00001.mp3`、`00002.mp3` …）后**重新拷一次**，再上电复位；
  3. 或直接用厂商上位机点播一首，确认模块自己能出声（这一步能彻底排除功放/喇叭/供电）。

按顺序做（全部用远程命令，不需要重烧）：

```
VSTOP          → 先停一次: 清"忙于播放"状态（实测 AB 回 00 = 被接受）
VCHECK         → 一条命令把 C0/C1/C2/C3/C9 全查一遍: 看 WTRXRAW(原始) / WTRX / WTRXINFO
                 （重点: files=? volume=? cur_file=?）
VPLAY 1        → 逐个索引扫（1/5/0…），看哪一条回帧变成 ret=0x00 并且出声
VOUT 0         → 强制切回 SPK 输出（喇叭接模块 SPK 脚 / 内部功放时用）
VOL 31         → 音量设到最大（掉电记忆，可能是 0 = 静音）
WTRAW 7E03AAADEF → AA 播放当前曲目（绕开索引: 出声说明引擎好、是索引问题）
WTRAW 7E03ACAFEF → AC 下一曲（同上）
```

* **模块自己能出声的独立验证**（不依赖本固件）：用厂商上位机让模块播一首
  （自检序列里已无 Key 步骤 —— 本项目标准品 Key 口没引出功能，需厂家定制，`VKEY` 会回 `ERR`）。
  → 能出声说明模块 / 功放 / 喇叭 / 供电都好，问题只在"文件 + 索引号"。
* **模块自己也不出声** → 直接查音频侧：文件格式/采样率是否被模块支持、音量是否为 0、
  喇叭是否接在 `SPK`（13/14 脚）、共地。

### 8.5 第二轮实测（20 步自检：把"索引问题"和"文件问题"分开）

第一轮（14 步）跑完的现场日志（片段）：

```
WTTX 7E 03 AB AE EF
PROBE 1/14 AB stop play (clear stuck busy state) rx=8
WTRXRAW 7E 04 AB 00 AF EF    WTRX AB 00        ← **AB 被接受**(数据 00), "卡在忙"的假设不成立
WTRXRAW 7E 04 AE 00 B2 EF                      ← AE 音量命令被接受
WTRXRAW 7E 04 C1 1F E4 EF    volume=31         ← 音量已是最大
WTRXRAW 7E 04 C3 05 CC EF    files=5           ← 模块认到 5 个文件
WTRXRAW 7E 05 C9 00 01 CF EF cur_file=1
WTTX 7E 03 C0 C3 EF          PROBE 8/14 ... rx=51
WTTX 7E 03 C2 C5 EF          PROBE 9/14 ... rx=77   ← **rx 涨了 26 字节, 却一行 WTRXRAW 都没有**
WTRXRAW 7E 04 C2 02 C8 EF    status=0x02
WTRXRAW 7E 04 A0 01 A5 EF    A0 ret=0x01        ← 索引 0: 回 01
WTRXRAW 7E 04 A0 02 A6 EF    A0 ret=0x02        ← 索引 1~4: 回 02
```

三条新结论：

1. `AB` 回 `AB 00` = 停止命令**被接受** → "模块卡在播放/忙"这个假设**基本不成立**（真被卡住的话，
   `AB` 之后就该能播了；可后面 5 个 `A0` 依然全被拒）。
2. **`A0` 索引 0 回 `01`、索引 1~4 回 `02`** —— 两个**不同**的返回码，说明模块区分了两种情况
   （"索引/参数无效" vs "索引有效但播不起来"）。至少可以确定：模块**认得这些索引**，
   只是**没能真的播放出来** → 嫌疑从"索引号填错"转向"模块播放不了这些文件（格式 / 文件系统）"。
3. `C0`（版本）那 26 字节"收了却没解析"：`WT2003_RX_FRAME_MAX` 原来是 16，而 C0 的回帧比它长，
   整帧被驱动**静默丢掉**（`rx` 一直涨、`WTRXRAW` 一行都没有）。现已把上限提到 32，并新增
   `WTRXBAD` 行打印"结构不对"的回帧（`wt2003_set_bad_frame_handler()`），以后不会再出现
   "字节收了却什么都看不见"。

所以自检序列改成 **20 步**，核心是加两个**绕过索引**的动作（这是把两类原因分开的唯一办法）：

| 步骤 | 发的东西 | 这一步要回答的问题 |
|---|---|---|
| 1 | `AB` 停止 | 清状态（排除"忙"） |
| 2~3 | `B6` DAC → `B6` SPK | 把输出方式修回 SPK（本硬件喇叭接 `SPK` 13/14 脚） |
| 4 | `AE` 音量 31 | 排除"音量掉电记成 0 = 静音" |
| 5~8 | `C1` / `C3` / `C9` / `C2` | 播放前的基准：音量 / 文件数 / 当前文件 / 状态 |
| 9 | `A0` 索引 1 | 按索引播（1-based 第一首） |
| 10~11 | `C9` / `C2` | 播完马上查：当前文件号**动了吗**？状态**变了吗**？ |
| 12 | `A0` 索引 5 | 补测 1-based 的最后一首（1~4 已知回 `02`，只剩 5 没测） |
| 13 | `A0` 索引 0 | 对照（已知回 `01`，用来判断返回码口径） |
| 14 | `AB` 停止 | 回到干净状态 |
| **15** | **`AA` 播放当前曲目** | **绕过索引**：出声 = 引擎好 → 就是索引的问题 |
| 16 | `C2` | 第 15 步到底播起来没有 |
| **17** | **`AC` 下一曲** | 同样绕过索引（让引擎自己选曲目） |
| 18 | `C2` | 第 17 步播起来没有 |
| 19 | `AB` 停止 | |
| 20 | `C0` 版本 | 确认模块型号 / 固件（长回帧，现在能打出来） |

判读只需看两件事：**（甲）第 15 / 17 步有没有声音；（乙）第 10 / 11 步的 `C9` / `C2` 有没有变化。**

* 有声音（哪怕只有一声）→ 模块、功放、喇叭、文件通通没问题，**只是 `A0` 的索引对不上** →
  用厂商上位机**重建曲目索引**（8.4 的办法 1 / 2）。
* `AA` / `AC` 也没声，且第 10 / 11 步 `cur_file` / `status` 毫无变化 → 模块**根本没在播** →
  **文件侧问题**：格式 / 采样率 / 码率不被支持，或文件系统被写坏 →
  用厂商上位机 + 标准 MP3（44.1kHz、CBR、根目录 `00001.mp3`…）重灌一遍。
* 第 20 步的 `ver=` 打出来是什么，也能帮着确认模块是不是本手册对应的型号 / 固件版本。

### 8.6 第三轮实测（20 步自检的现场日志）

20 步自检跑完的现场日志（要点，`rx` 累计 131 字节）：

```
WTRXRAW 7E 04 AB 00 AF EF              WTRX AB 00    ← AB(停止) 被接受
WTRXRAW 7E 04 AA 00 AE EF              WTRX AA 00    ← **AA(播放/暂停) 也回 00 = 被接受!**
WTRXRAW 7E 04 AC 01 B1 EF              WTRX AC 01    ← AC(下一曲) 回 01
WTRXRAW 7E 04 A0 02 A6 EF              WTRX A0 02    ← A0 索引 1 / 5 都回 02
WTRXRAW 7E 04 A0 01 A5 EF              WTRX A0 01    ← A0 索引 0 回 01
WTRXRAW 7E 05 C9 00 01 CF EF           cur_file=1    ← 从头到尾没变过
WTRXRAW 7E 04 C2 02 C8 EF              status=0x02   ← 从头到尾没变过
WTRXRAW 7E 18 C0 57 54 53 32 35 31 ... 81 EF
                                       ver=WTS251016-70-A01V4.01 (len=21)
```

**重点：全部无声（连一声"咔哒"都没有），但几乎所有命令都被回 `00`（成功）。**

先把协议这件事钉死（这一条能省掉大量弯路）：

* `C0` 的回帧 `7E 18 C0 "WTS251016-70-A01V4.01" 81 EF`，按手册口径验算校验和 ——
  `0x18 + 0xC0 + Σ(21 个字符) = 0x581`，低字节 **`0x81`**，与帧里印的校验码**完全一致**。
  → **帧格式、波特率、收发接线全部正确**，问题不在通信层。
* 版本串 `WTS251016-70-A01V4.01` 说明这是**厂家定制固件**（`WTS251016` 像生产批次/日期），
  它的行为不一定等同于公开手册里的标准固件（例如可能被配置成**上电自动播放**）。

于是原因被压缩成两条路，第三轮 30 步自检就是用来劈开它们的：

| 观测点 | 说明什么 |
|---|---|
| 第 13 步 `A0` 在 `AA`（暂停）之后**回 `00`** | 第 8 步的 `02` 是**"忙碌拒绝"** → 模块**其实一直在播**（多半是上电自动播放）→ 问题在**音频输出侧**（见下） |
| 第 18 / 21 步（DAC 通路 / SPK 通路各试播一次）有没有声 | 有声的那一档 = 正确的输出方式 / 接法；两档都无声 → 功放 / 喇叭 / 供电 |
| 第 10 / 11 / 24 / 26 步 `C9`/`C2` 的 `CHANGED!` | 变了 = 引擎真的在动（换曲 / 播放）; 一直 `UNCHANGED` = 引擎根本没动 |
| 第 27 / 28 步 `A0 01 01` / `A0 02 01` | 试探 `A0` 两个数据字节的第一个是不是"存储介质 / 盘号"（Flash/TF/U盘 三选一的固件） |

**硬件侧同时要排的三件事**（很多"命令全对但没声"最后都是这里）：

1. **喇叭必须接 `SPK+` 与 `SPK-` 两端**（模块内部是 BTL 桥接功放）。
   只接 `SPK+`/喇叭另一端接 `GND` 会**永远无声**，而且模块自检完全正常。
2. 供电与共地：模块 `VCC`（3.3V / 5V 按板子）要稳，和 MCU **共地**（串口能通说明已共地）。
3. 上电后**贴近喇叭听**：若有轻微底噪/电流声 = 功放已工作、只是没有解码输出；完全死寂 = 功放/喇叭回路断。

判读（对应处理办法）：

* **第 18 或 21 步有声音** → 输出方式/接法确定，回去查正式流程为什么不出声（见 8.10 的收尾；
  第五轮结论见 **8.9**：本模块 `A6` 不出声，正式播指定语音要用 `A7` 按文件名）。
* **两档都没声、`C9`/`C2` 一直 `UNCHANGED`** → 模块**根本没在播**，且 `A0` 的 `02` 不是"忙"而是
  "无法播放该文件" → 文件侧：格式 / 采样率 / 码率不被支持，或文件系统被写坏 →
  用厂商上位机 + 标准 MP3（44.1kHz、CBR、根目录 `00001.mp3`…）重灌，重灌后**重新上电**。
* **两档都没声但 `AA` 回 `00` / `AC` 回 `01`** → 命令被接受却没输出，重点转向**硬件**（上面 1~3 条），
  尤其 `SPK` 的 BTL 接法；也可用厂商上位机**独立验证**模块自己能不能出声（这一步能把固件与硬件彻底分开）。
* 出现新的 `WTRXBAD` 行 → 回帧长度/帧尾与手册口径不同，把整行发出来分析（`WT2003_RX_FRAME_MAX`
  已提到 32，不会再有"字节收了却看不见"的情况）。

### 8.7 第四轮实测（38 步：U 盘口径 + 返回码取证）

现场日志（要点，`PROBE DONE rx=190`；每一步的原样字节都能在 `s_probe_tab` 里对上）：

```
WTTX 7E 04 D2 02 D8 EF        WTRX D2 05      ← D2 切盘符 = U 盘: 回 0x05(手册示例是 00)
WTTX 7E 04 B6 00 BA EF        WTRX B6 00      ← B6 输出 = SPK: 回 00
WTTX 7E 04 AE 1F D1 EF        WTRX AE 00      ← AE 音量 31: 回 00
WTTX 7E 03 C1 C4 EF           WTRX C1 1F      ← volume=31 (音量已满)
WTTX 7E 03 CA CD EF           WTRX CA 00      ← conn=0x00: PC=0 UDISK=0 FLASH=0
WTTX 7E 03 C7 CA EF           WTRX C7 05      ← udisk_files=5   ★ 和上一条自相矛盾!
WTTX 7E 03 C9 CC EF           WTRX C9 00 01   ← cur_file=1
WTTX 7E 03 C2 C5 EF           WTRX C2 02      ← status=0x02 = STOPPED
WTTX 7E 05 A6 00 01 AC EF     WTRX A6 05      ← A6 试播索引 1: 回 0x05(手册示例是 00)
WTTX 7E 03 AC AF EF           WTRX AC 00      ← 下一曲
WTTX 7E 03 C9 CC EF           WTRX C9 00 02   ← cur_file=2 (CHANGED!)
WTTX 7E 03 AD B0 EF           WTRX AD 00      ← 上一曲
WTTX 7E 03 C9 CC EF           WTRX C9 00 01   ← cur_file=1 (CHANGED!)
```

**现场结论：这几步里喇叭确实出声了。**

三条钉死的判读：

1. **通信层 100% 正常**：每条命令都拿到了结构自洽的回帧（`长度 = 长度+命令码+参数+校验和`，
   校验和 = 前三者累加和的低字节），且回帧里的 `cmd` 一定是刚发出去的那条 —— 没有错帧、没有丢帧。
   所以"没声音"这件事从来不在 MCU 侧（`C0` 版本帧的校验和也完全吻合，见 8.6）。
2. **本固件的返回码口径 ≠ 手册**：手册 4.1.3.1 只定义 `00 = OK / 01 = FAIL(出错, 不执行) /
   02 = EMP(无此文件)`，而实测 `D2 / A6 / C7` 都回 `0x05`，同一轮里**音频照样播出来了**。
   （巧合的是 `0x05` 正好等于 `CA` 连接位图里的 `bit2(U盘) | bit0(Flash)`；
   不管它到底表示什么，**都不能当成失败**。）第 31~38 步就是用来钉死它的。
3. **`CA` / `C2` 这两条查询在本固件上不完全可信**：
   * `CA = 00`（U 盘位 = 0）却 `C7 = 05`（U 盘上 5 个文件）—— 同一轮里自相矛盾；
   * `C2` 全程 `02 = 停止`，可 `AC` / `AD` 明明把 `cur_file` 从 1 推到 2 又推回 1。
   ⇒ 判断**介质**看 `C7`（文件数非 0 = 模块真扫到了文件），判断**有没有声**看**耳朵**，
   别只看 `CA` / `C2`。

第 31~38 步要回答的问题（跑完把日志发出来即可）：

| 步 | 发的东西 | 想看到什么 |
|---|---|---|
| 31 | `C3` | 和第 7 步 `C7` 对比 —— **实测两条口径一样（都回 `05`，均 1 字节）**，所以 `C3` 不是 Flash/U 盘判别位（手册虽写 Flash，本模块不成立） |
| 32 | `A6 00 63`（索引 99，绝不存在） | 若回 `02` ⇒ 手册返回码表在本固件生效，那 `0x05` 只是"U 盘类命令的另一种应答"；<br>若也回 `05` ⇒ 本固件返回码口径完全另说，一切以耳朵为准 |
| 33 | `C2` | 那次"失败"的 `A6` 有没有影响状态 |
| 34 | `A6 00 00`（索引 0） | 索引从 0 还是从 1 开始（手册 4.1.4.5 示例写"索引 `0001` = 第 2 首"）—— **听** |
| 35 | `C2` | 短间隔再查：有没有变成 `01 = 播放` |
| 36 | `A0 00 01`（Flash 索引 1） | Flash 里真没文件时应回 `02`，交叉验证第 31 步 |
| 37~38 | `C9` / `C2` | 收尾 |

出声了也别省这两条硬件复核（最容易反复）：

* 喇叭接 **`SPK+` 与 `SPK-` 两端**（模块内部是 BTL 桥接功放）；任一端接 `GND` 会变成
  "时响时不响"甚至完全无声，而自检看上去一切正常。
* U 盘：`D+` / `D-` / `5V` / `GND` 四根都要接，格式 **FAT / FAT32**，音频放**根目录**，
  索引按文件拷贝顺序排；`C7` 回非 0 才能证明模块真的扫到了。

### 8.9 第五轮实测（**根因定论**：本模块 `A6` 收下命令但不出声 → 改用 `A7` 按文件名播放）

第五轮把自检缩到"只会出声的那几步"逐条听，结果非常干净：

| 自检步 | 发出的命令 | 耳朵听到的 |
|---|---|---|
| 25 | `AC` 下一曲 | **有声**（第 26 步 `C9` 由 1 → 2） |
| 27 | `AD` 上一曲 | **有声**（第 28 步 `C9` 由 2 → 1） |
| 10 / 15 / 20 / 23 / 29 / 32 / 34 | `A6` 播 U 盘索引 1 / 2 / 99 / 0 | **全程无声**，`C9` 也从未因它变化 |

由此得到的结论（这就是"应用里没声音"的根因）：

1. **索引 1 的文件确实存在**（`AD` 能把它播出来），而 `A6 索引 1` 连发 4 次都无声
   ⇒ **不是索引号 / 文件的问题，是本模块的 `A6`（指定 U 盘根目录索引播放）收下命令但不播**
   （它只回一个固定字节 `05`）。
2. **播放引擎与音频链路完全正常**：`AC` / `AD` 从"停止态"也能起播，`C1 = 1F`（音量满）、
   `B6 = SPK`、每一步的帧长度/校验都对 ⇒ 硬件、接线、协议都没问题。
3. 所以 8.4~8.7 里"改用 `A6` 就有声"的说法**不成立**（那几轮听到的声音其实来自后面的
   `AC`/`AD` 步骤）；正式播指定语音请改走 **`A7` 按文件名播放**。

#### 8.9.1 前置条件（硬件 + 文件）

* U 盘：`D+` / `D-` / `5V` / `GND` 四根都接；格式 **FAT / FAT32**；音频放**根目录**。
* 喇叭接 **`SPK+` 与 `SPK-` 两端**（模块内部是 BTL 桥接功放）；任一端接 `GND` 会永远无声。
* **`A7` 要求文件名固定 4 个字符**（扩展名另算）：`T001.mp3` / `T002.mp3` … →
  命令数据就是 `"T001"` / `"T002"`
  （帧 `7E 07 A7 54 30 30 31 93 EF` = 播 `T001.mp3`，`7E 07 A7 54 30 30 32 94 EF` = 播 `T002.mp3`；
  长度 `07 = 1(自身) + 1(命令) + 4(名字) + 1(校验)`，校验 = 从长度字节起逐字节累加取低字节）。

#### 8.9.2 新增"按文件名轮播"（当前固件默认开启）

| 配置（`Inc/bsp_config.h`） | 当前值 | 说明 |
|---|---|---|
| `WT2003_PROBE_ON_BOOT` | **`0`** | 38 步自检**已关闭**（第五轮结论已拿到，不再上电跑） |
| `WT2003_NAME_CYCLE_ON_BOOT` | `1` | 上电即开始按文件名轮播 |
| `WT2003_NAME_CYCLE_MS` | `4000` | **每 4 秒播下一个文件**（要 ≥ 单个音频时长，否则下一首会切掉上一首） |
| `WT2003_NAME_CYCLE_QUERY_MS` | `800` | 播后 0.8 秒自动查一次 `C9` + `CB`，确认"模块到底播的是哪一首" |
| `WT2003_NAME_CYCLE_LIST` | `{"T001"…"T005"}` | 按 U 盘里的**真实文件名**改（`C7 = 5` 说明模块认到 5 个文件） |

上电后的日志形态（听到声音时直接对名字）：

```
NAME 1/5 "T001" play by file name (A7), rx=12
WTTX 7E 07 A7 54 30 30 31 93 EF      ← A7 播文件名 "T001"(长度 07 = 1+1+4+1, 校验 93)
WTRXRAW 7E 04 A7 00 AB EF            WTRXINFO A7 ret=0x00
WTRXINFO cur_file=1                  ← C9: 播放指针动了吗
WTRXINFO name="T001.mp3"             ← CB: 模块实际在播的名字(能对上 = A7 生效)
```

> `A7` 的回码同样可能是本固件私有的 `05`（像 `A6`/`D2`/`C7` 那样）——
> **回 `00` 还是 `05` 都不代表结果**，请以"耳朵 + `CB` 的 `name=`"为准。

判读：

* `cur_file` / `name=` 都跟着变 ⇒ `A7` 生效：把 `WT2003_NAME_CYCLE_LIST` 换成真实名字，
  业务层直接调 `wt2003_play_udisk_name("T00n")` 就能点播。
* 有声但 `name=` 是空 / 老值 ⇒ 名字没对上（不在根目录 / 不是 4 字符 / 大小写不符）。
* 完全无声且 `A7` 回 `01` / `02` ⇒ 名字不存在（`02 = EMP` 无此文件），按 8.9.1 核对文件名。

#### 8.9.3 远程命令（不重烧也能试，见第 4 节命令表）

| 命令 | 作用 | 回文 |
|---|---|---|
| `VNAME` | 列出配置里的名字表 | `OK VNAME n=5 every=4000ms` + 每行 `NAME 1 "T001"` |
| `VNAME 3` | 立刻用 `A7` 播第 3 个名字 | `OK VNAME 3 = "T003" (A7 U-disk by name, see WTRX)` |
| `VNAMEON` / `VNAMEOFF` | 开 / 关"每 4 秒播下一个"的轮播 | `OK VNAMEON 5 files, 4000 ms each` |

驱动接口：`wt2003_name_start / stop / fire / count / get / set_handler`（`drv_wt2003h.h`）。
`wt2003_name_start()` 与 `wt2003_probe_start()` **互斥**（谁后开谁生效），
避免两套时序交叉把日志搅乱。

### 8.10 收尾
`WT2003_PROBE_ON_BOOT` / `WT2003_NAME_CYCLE_ON_BOOT` 选一个为 `1`（其余 `0`）、
`WT2003_TX_TRACE` / `WT2003_RX_TRACE` 根据需要置 `0`（正式固件静默）；
`WTPROBE` / `WTSTOP` / `WTST` / `WTRAW` / `VOUT` / `VQRY` / `VCHECK` / `VPLAY` / `VPLAY6` / `VPLAY0` /
`VNAME` / `VNAMEON` / `VNAMEOFF` / `VKEY`
可留着当维护工具（不收到命令就不动作）。

~~~~

<!-- ===================== D : Doc/removed_main_trace.txt ===================== -->

~~~~
<!-- ======== 涓嬮潰杩欐鏄粠 Src\main.c 绗?47~415 琛岀Щ闄ょ殑鍘熸枃(鐣欐。) ======== -->
/*---------------------------------------------------------------------------*/
/* 上电语音探测的进度显示(调试用):
   数码管前两位 00, 后两位 = 正在试第几步(01~30);
   探测结束时显示"模块回帧计数"的低 4 位 —— 全 0000 说明模块一句都没回, 那就是
   接线/波特率/模块模式的问题, 而不是帧格式问题。
   同一条进度还会从 ESP32 串口(USART1)打一行 ASCII, 数码管不正常时也能看。 */
#if (WT2003_PROBE_ON_BOOT != 0U)
static void wt2003_probe_show(uint8_t step, uint8_t total)
{
    char     buf[5];
    uint32_t rx;

    rx = wt2003_rx_total();

    if (step == 0xFFU)              /* 探测结束 */
    {
        buf[0] = (char)('0' + (char)((rx / 1000U) % 10U));
        buf[1] = (char)('0' + (char)((rx / 100U) % 10U));
        buf[2] = (char)('0' + (char)((rx / 10U) % 10U));
        buf[3] = (char)('0' + (char)(rx % 10U));
        buf[4] = '\0';
        hc595_show_digits(buf);
        /* 数码管万一不亮也能看: 同一句话再从 ESP32 串口打一行出去 */
        esp32_printf("PROBE DONE rx=%lu cmd=%lu %s\r\n", (unsigned long)rx,
                     (unsigned long)wt2003_cmd_count(),
                     (rx == 0UL) ? "module silent: check wiring/baud/mode"
                                 : "read WTRXINFO: CA=conn C7=udisk_files C3=flash_files C9=cur C2=status A6 ret (ret 05 still plays!)");
        return;
    }

    buf[0] = '0';
    buf[1] = '0';
    buf[2] = (char)('0' + (char)((step / 10U) % 10U));
    buf[3] = (char)('0' + (char)(step % 10U));
    buf[4] = '\0';
    hc595_show_digits(buf);         /* 0001 = 第 1 种帧, 0002 = 第 2 种 ... */
    esp32_printf("PROBE %u/%u %s rx=%lu\r\n", (unsigned)step, (unsigned)total,
                 wt2003_probe_cfg_hint(step), (unsigned long)rx);
}
#endif

/*---------------------------------------------------------------------------*/
/* 按文件名轮播的进度显示(WT2003_NAME_CYCLE_ON_BOOT = 1 时):
   数码管前两位 00, 后两位 = 正在播第几个文件名(01~); 串口同时打一行
   NAME n/N "T00n" play by file name (A7) —— 听到声音就对照这一行看是哪个文件名;
   播后驱动会自动发 C9/CB, 于是还会跟出 WTRXINFO cur_file= / name=,
   能直接确认"模块到底播的是不是这一个文件"。 */
#if (WT2003_NAME_CYCLE_ON_BOOT != 0U)
static void wt2003_name_show(const char *name, uint8_t n, uint8_t total)
{
    char buf[5];

    buf[0] = '0';
    buf[1] = '0';
    buf[2] = (char)('0' + (char)((n / 10U) % 10U));
    buf[3] = (char)('0' + (char)(n % 10U));
    buf[4] = '\0';
    hc595_show_digits(buf);

    esp32_printf("NAME %u/%u \"%s\" play by file name (A7), rx=%lu\r\n",
                 (unsigned)n, (unsigned)total, (name != NULL) ? name : "?",
                 (unsigned long)wt2003_rx_total());
}
#endif

/*---------------------------------------------------------------------------*/
/* 语音模块"发/收"帧的实时打印(排查用, 由 WT2003_RX_TRACE / WT2003_TX_TRACE 开关):
   以前必须挂调试器看驱动的 s_rx_buf 才知道"模块到底回了什么"(而且那里是环形缓冲的
   原貌, 还夹着上一帧的残留字节), 现在每次收发都从 ESP32 串口(USART1, 115200)打一行:
       WTTX 7E 05 A6 00 01 AC EF   主机"真正发出去"的原始字节(默认 A6 播 U 盘索引 1)
       WTRXRAW 7E 04 A6 00 AA EF   模块回帧的原始字节(含 7E/长度/校验码/EF)
       WTRX A6 00                  同一帧解析后的结果(命令码 + 数据区)
   判读要点(手册 4.1.3.4 指定 U 盘根目录索引播放):
       发 -> 7E 05 A6 00 02 AD EF   长度 05 = 1(自身) + 1(命令) + 2(曲目号) + 1(校验码)
       收 <- A6 00                   手册写的应答(命令 + 处理结果)
      返回码(手册 4.1.3.1"写操作指令返回码格式"): 00 = OK / 01 = FAIL(出错, 不执行) /
      02 = EMP(无此文件)。实测本模块 A6 / D2 / C7 都回 0x05(手册里没定义),
      而那几轮音频照样出声 -> 非 0 不等于"没播", 有没有声以耳朵为准(见 README 8.7)。
     实测模块回帧是"带 7E/长度/校验码/EF 的整帧"(如 A0 索引 1 实收 7E 04 A0 00 A4 EF),
     驱动对"整帧"和"裸命令+数据"两种口径都做了兼容解析。
     A0(SPI Flash)结构相同, 只是命令码不同: 发 7E 05 A0 00 01 A6 EF。 */

#if ((WT2003_RX_TRACE != 0U) || (WT2003_TX_TRACE != 0U))
/* 打一行 "<tag> XX XX ..." 到 ESP32 串口(tag 最长 7 字符, 内部已按最大帧长算过缓冲) */
static void wt2003_hex_line(const char *tag, const uint8_t *p, uint8_t len)
{
    static const char s_hex[] = "0123456789ABCDEF";
    char              buf[8U + 3U * (WT2003_RX_FRAME_MAX + 3U) + 2U];
    uint8_t           n = 0U;
    uint8_t           i;

    for (i = 0U; (tag[i] != '\0') && (i < 7U); i++)
    {
        buf[n] = tag[i];
        n++;
    }

    if (len > (uint8_t)(WT2003_RX_FRAME_MAX + 3U))   /* 防御: 超长直接截断 */
    {
        len = (uint8_t)(WT2003_RX_FRAME_MAX + 3U);
    }

    for (i = 0U; i < len; i++)
    {
        buf[n]      = ' ';
        buf[n + 1U] = s_hex[(uint8_t)((p[i] >> 4) & 0x0FU)];
        buf[n + 2U] = s_hex[(uint8_t)(p[i] & 0x0FU)];
        n           = (uint8_t)(n + 3U);
    }

    buf[n]      = '\r';
    buf[n + 1U] = '\n';
    n           = (uint8_t)(n + 2U);

    esp32_send((const uint8_t *)buf, (uint16_t)n);
}
#endif

#if (WT2003_RX_TRACE != 0U)
/* 写命令返回码口径(手册 4.1.3.1 "写操作指令返回码格式"): 模块回 <命令码> <1 字节操作码>。
     0x00 = OK   命令执行
     0x01 = FAIL 命令出错, 不执行
     0x02 = EMP  无此文件
   0x05 手册没定义, 但本模块对 D2 / A6 / C7 这三条"带 U 盘"的命令都回 0x05,
   而且同一轮里喇叭确实出声了 —— 所以 0x05 绝不能当成"没播"(见 README)。
   查询命令(C1/C2/C3/C7/C8/C9/CA/CB)回的是"数据", 不是返回码, 别混用这张表。 */
static const char *wt2003_ret_name(uint8_t r)
{
    switch (r)
    {
        case 0x00U: return "OK";
        case 0x01U: return "FAIL (command error, not executed)";
        case 0x02U: return "EMP (no such file)";
        case 0x05U: return "0x05 (undocumented; U-disk cmds answer it, audio still plays)";
        default:    return "unknown";
    }
}

static void wt2003_rx_show(uint8_t cmd, const uint8_t *data, uint8_t len)
{
    uint8_t        all[WT2003_RX_FRAME_MAX + 1U];
    const uint8_t *raw;
    uint8_t        raw_len = 0U;
    uint8_t        i;

    /* ① 原始回帧: 连 7E / 长度 / 校验码 / EF 一起打, 便于与手册示例逐字节对照 */
    raw = wt2003_last_rx_raw(&raw_len);
    if ((raw != NULL) && (raw_len != 0U))
    {
        wt2003_hex_line("WTRXRAW", raw, raw_len);
    }

    /* ② 解析结果: 命令码 + 数据区(驱动已剥掉校验码) -> "WTRX A0 00" */
    all[0] = cmd;
    for (i = 0U; (i < len) && (i < (uint8_t)WT2003_RX_FRAME_MAX); i++)
    {
        all[i + 1U] = data[i];
    }
    wt2003_hex_line("WTRX", all, (uint8_t)(i + 1U));

    /* ③ 解析结果 -> 翻成"人话"再打一行给 ESP32(WTRXINFO): 一眼看出模块里边有
          几个文件、音量多少、在播第几首、A0 到底有没有真的开始播放。
          这条打印链路就是 手机 -> ESP32 -> USART1 -> 本机, 所以 ESP32 侧能直接看到。 */
    switch (cmd)
    {
        case WT2003_CMD_GET_VERSION:     /* C0: 版本(实测回帧比手册写的长, 顺便翻成 ASCII 看是不是版本串) */
            if (len >= 1U)
            {
                char    txt[WT2003_RX_FRAME_MAX + 1U];
                uint8_t k;
                uint8_t m = (len < (uint8_t)WT2003_RX_FRAME_MAX) ? len : (uint8_t)WT2003_RX_FRAME_MAX;

                for (k = 0U; k < m; k++)
                {
                    txt[k] = ((data[k] >= 0x20U) && (data[k] < 0x7FU)) ? (char)data[k] : '.';
                }
                txt[m] = '\0';
                esp32_printf("WTRXINFO ver=%s (len=%u, hex on the WTRX line above)\r\n", txt, (unsigned)len);
            }
            break;

        case WT2003_CMD_GET_VOLUME:      /* C1: 1 字节音量 0~31(0 = 静音) */
            if (len >= 1U)
            {
                esp32_printf("WTRXINFO volume=%u (0=silent, 31=max)\r\n", (unsigned)data[0]);
            }
            break;

        case WT2003_CMD_GET_STATUS:      /* C2: 1 字节工作状态(含义见手册表 4; 实测恒为 0x02) */
            if (len >= 1U)
            {
                /* 状态有没有"变"是本轮最关键的信息: 一直不变 = 模块从头到尾都在同一个
                   状态(自认为在播/占线 或 根本没动), 会变 = 命令真的起作用了 */
                static uint8_t s_prev_st = 0xFFU;
                const char    *tag;

                if (s_prev_st == 0xFFU)
                {
                    tag = "(first read)";
                }
                else if (s_prev_st == data[0])
                {
                    tag = "(UNCHANGED)";
                }
                else
                {
                    tag = "(CHANGED!)";
                }

                /* 手册 4.1.4.2: 0x01 = 播放, 0x02 = 停止, 0x03 = 暂停。
                   注意: 本轮实测里 C2 从头到尾都是 02(停止), 而同轮 A6 回 0x05 + 喇叭有声
                   -> 本固件的 C2 并不完全跟着 U 盘播放走, 别只凭 C2 判断"有没有出声"。 */
                esp32_printf("WTRXINFO status=0x%02X %s %s\r\n", (unsigned)data[0], tag,
                             (data[0] == 0x01U) ? "[PLAYING]"
                                                : ((data[0] == 0x02U) ? "[STOPPED]"
                                                                      : ((data[0] == 0x03U) ? "[PAUSED]" : "[?]")));
                s_prev_st = data[0];
            }
            break;

        case WT2003_CMD_GET_FILE_NUM:    /* C3: 文件总数(手册 4.1.4.3 写 SPI-Flash; 实测本模块
                                            C3 与 C7 同为 1 字节口径, 不能用来判介质) */
            if (len >= 2U)
            {
                esp32_printf("WTRXINFO flash_files=%u (SPI-Flash; compare with C7 udisk_files)\r\n",
                             (unsigned)(((uint16_t)data[0] << 8) | (uint16_t)data[1]));
            }
            else if (len >= 1U)
            {
                esp32_printf("WTRXINFO flash_files=%u (SPI-Flash, 1-byte reply; compare with C7)\r\n",
                             (unsigned)data[0]);
            }
            break;

        case WT2003_CMD_GET_UDISK_NUM:   /* C7: 查询 U 盘内音乐文件总数(手册 4.1.4.4) <== 本工程看这条 */
        case WT2003_CMD_GET_UFOLDER_NUM: /* C8: 查询 U 盘指定文件夹内文件总数(手册 4.1.4.5) */
            if (len >= 2U)
            {
                uint16_t n = (uint16_t)(((uint16_t)data[0] << 8) | (uint16_t)data[1]);

                esp32_printf("WTRXINFO udisk_files=%u %s\r\n", (unsigned)n,
                             (n == 0U) ? "[0 = module sees NO file on the U-disk!]"
                                       : "[ok: the module really sees files on the U-disk]");
            }
            else if (len >= 1U)
            {
                /* 本模块这条只回 1 字节(手册写 2 字节) —— 数量有限, 1 字节足够 */
                esp32_printf("WTRXINFO udisk_files=%u (U-disk, 1-byte reply) %s\r\n",
                             (unsigned)data[0],
                             (data[0] == 0U) ? "[0 = module sees NO file on the U-disk!]"
                                             : "[ok: the module really sees files on the U-disk]");
            }
            break;

        case WT2003_CMD_GET_CONN:        /* CA: 查询当前外设连接状态(手册 4.1.4.7) */
            if (len >= 1U)
            {
                /* bit3 = PC 连接, bit2 = U 盘, bit0 = SPI-Flash; 1 = 存在(手册 4.1.4.7)。
                   注意: 本模块实测出现过 CA=0x00(U 盘位 = 0) 但 C7 回 5 个 U 盘文件、
                   且 A6 能播出声音的情况 -> CA 这条查询在本固件上不完全可信,
                   "盘认没认到"要 CA + C7 两条一起看。 */
                esp32_printf("WTRXINFO conn=0x%02X PC=%u UDISK=%u FLASH=%u\r\n",
                             (unsigned)data[0],
                             (unsigned)((data[0] >> 3) & 0x01U),
                             (unsigned)((data[0] >> 2) & 0x01U),
                             (unsigned)(data[0] & 0x01U));
            }
            break;

        case WT2003_CMD_GET_CUR_NAME:    /* CB: 查询当前播放歌曲名(手册 4.1.4.8, 8 字节 ASCII) */
            if (len >= 1U)
            {
                char    nm[9];
                uint8_t k;
                uint8_t m = (len < 8U) ? len : 8U;

                for (k = 0U; k < m; k++)
                {
                    nm[k] = ((data[k] >= 0x20U) && (data[k] < 0x7FU)) ? (char)data[k] : '.';
                }
                nm[m] = '\0';
                esp32_printf("WTRXINFO name=\"%s\"\r\n", nm);
            }
            break;

        case WT2003_CMD_GET_CUR_FILE:    /* C9: 2 字节当前播放文件号(高字节在前) */
            if (len >= 2U)
            {
                /* 播放中/换曲时"当前文件"应该跟着动; 一直不动 = 引擎根本没换过曲目 */
                static uint16_t s_prev_cur = 0xFFFFU;
                uint16_t        cur;
                const char     *tag;

                cur = (uint16_t)(((uint16_t)data[0] << 8) | (uint16_t)data[1]);

                if (s_prev_cur == 0xFFFFU)
                {
                    tag = "(first read)";
                }
                else if (s_prev_cur == cur)
                {
                    tag = "(UNCHANGED)";
                }
                else
                {
                    tag = "(CHANGED!)";
                }

                esp32_printf("WTRXINFO cur_file=%u %s\r\n", (unsigned)cur, tag);
                s_prev_cur = cur;
            }
            break;

        case WT2003_CMD_PLAY_INDEX:      /* A0: SPI-Flash 根目录索引播放的返回码(手册 4.1.3.2) */
            if (len >= 1U)
            {
                esp32_printf("WTRXINFO A0(SPI-Flash) ret=0x%02X = %s\r\n",
                             (unsigned)data[0], wt2003_ret_name(data[0]));
            }
            break;

        case WT2003_CMD_PLAY_UFLASH:     /* A6: U 盘根目录索引播放的返回码(手册 4.1.3.4) */
            if (len >= 1U)
            {
                esp32_printf("WTRXINFO A6(U-disk) ret=0x%02X = %s\r\n",
                             (unsigned)data[0], wt2003_ret_name(data[0]));
            }
            break;

        case WT2003_CMD_SET_DRIVE:       /* D2: 切换当前工作盘符(手册 4.1.3.16) */
            if (len >= 1U)
            {
                esp32_printf("WTRXINFO D2(drive switch) ret=0x%02X = %s\r\n",
                             (unsigned)data[0], wt2003_ret_name(data[0]));
            }
            break;

        case WT2003_CMD_PLAY_FLASHNAME:  /* A1: SPI-Flash 按文件名播放(手册 4.1.3.3) */
        case WT2003_CMD_PLAY_UNAME:      /* A7: U 盘按文件名播放(手册 4.1.3.5) */
        case WT2003_CMD_PLAY_UFOLDER:    /* A8: U 盘文件夹内索引播放(手册 4.1.3.6) */
        case WT2003_CMD_INSERT:          /* B1: 插播命令(手册 4.1.3.13) */
            if (len >= 1U)
            {
                esp32_printf("WTRXINFO cmd=0x%02X ret=0x%02X = %s\r\n",
                             (unsigned)cmd, (unsigned)data[0], wt2003_ret_name(data[0]));
            }
            break;

        default:
            break;                       /* 其余命令含义不明确的不猜, 看上面的 WTRX 原始行 */
    }
}

/* 结构不对的回帧(帧尾不是 EF / 帧长超缓冲)也原样打出来:
   以前这类字节会被驱动静默丢掉, 就会出现"字节数涨了却一行 WTRXRAW 都没有"的怪现象
   (实测 C0 版本查询的回帧就有这个问题, 见 README 8.4)。 */
static void wt2003_bad_show(const uint8_t *raw, uint8_t len)
{
    wt2003_hex_line("WTRXBAD", raw, len);
    esp32_printf("WTRXINFO bad frame (tail != EF or too long), bytes=%u\r\n", (unsigned)len);
}
#endif

#if (WT2003_TX_TRACE != 0U)
static void wt2003_tx_show(const uint8_t *frame, uint8_t len)
{
    wt2003_hex_line("WTTX", frame, len);
}
#endif

~~~~

<!-- ===================== E : Doc/removed_main_boot.txt ===================== -->

~~~~
<!-- ======== 涓嬮潰杩欐鏄粠 Src\main.c 绗?541~600 琛岀Щ闄ょ殑鍘熸枃(鐣欐。) ======== -->
    /*----------------------- 9. 上电演示 -------------------------*/
    /* 上电语音有两条路, 由 WT2003_PROBE_ON_BOOT 选择:
       - 正式模式(WT2003_PROBE_ON_BOOT = 0): 先等 WT2003_BOOT_DELAY_MS(模块上电要做
         内部初始化, 命令发得太早会被忽略, 表现为开机没声音; 觉得等太久就调小), 再设
         音量, 最后固定走串口(USART3)播放 WT2003_BOOT_VOICE 号音频(命令码默认 0xA6
         播 U 盘根目录索引 + 2 字节曲目号; 用 A0 播 SPI Flash 由 WT2003_PLAY_USE_UDISK=0 选)。
       - 自检模式(= 1): 上电自动跑 38 步体检(见 drv_wt2003h.c 的 s_probe_tab):
             1~7   设置与查询: AB 停止 / B6=SPK / AE 音量31 / C1音量 / C3文件数 / C9当前文件 / C2状态
                   喇叭必须接在 SPK+ 与 SPK- 两端(BTL), 一端接 GND 则永远无声
             8     A6 播放索引 1(U 盘)                 <- 听! (第 1 次试播)
             9~10  C9/C2(有变化吗; 打印后面带 UNCHANGED / CHANGED!)
             11    AA 播放/暂停(把"自认为在播"的东西暂停掉)
             12    C2(暂停后的状态)
             13    A6 播放索引 1 再来(U 盘)       <- 听! 这步回 00 = 第 8 步的 02 是"忙碌拒绝"
             14~15 C9/C2
             16    AB 停止
             17    B6 输出 = DAC(试另一条输出通路)
             18    A6 播放索引 1(DAC 模式)             <- 听!
             19~20 AA 播放/暂停 / B6 输出 = SPK(切回)
             21    A6 播放索引 1(SPK 模式)             <- 听!
             22~23 C2 / AC 下一曲 + C9    24~26 AD 上一曲 + C9(cur_file 在 1 与 2 之间跳吗)
             27~28 A6 播放索引 2 / 3(扫 U 盘文件索引, 回 00 = 该索引有文件可播)
             29~30 AB 停止 + C2(最终状态)
         每一步的 WTTX/WTRX/WTRXINFO 都会从 ESP32 串口打出来, 数码管显示步号;
         排查完把 WT2003_PROBE_ON_BOOT 改回 0。
       注: 这里明确要"串口通路", 所以用 wt2003_talk_src() 指定 SRC_UART
       (Key 口关闭时 wt2003_talk() 本来也会走串口, 写上更直白)。 */
#if (WT2003_RX_TRACE != 0U)
    /* 模块返回帧 -> 从 ESP32 串口打一行 "WTRXRAW ..."/"WTRX ..." (免得为看回帧去挂调试器) */
    wt2003_set_frame_handler(wt2003_rx_show);
    /* 结构不对的回帧(帧尾非 EF / 超长)也要打出来, 否则"字节收了却看不见"没法判断 */
    wt2003_set_bad_frame_handler(wt2003_bad_show);
#endif
#if (WT2003_TX_TRACE != 0U)
    /* 主机发帧 -> 从 ESP32 串口打一行 "WTTX ..." (一眼确认"到底发出去几个字节") */
    wt2003_set_tx_handler(wt2003_tx_show);
#endif
    bsp_delay_ms(WT2003_BOOT_DELAY_MS);
    (void)wt2003_set_volume(WT2003_DEFAULT_VOLUME);
#if (WT2003_PROBE_ON_BOOT != 0U)
    /* 自检模式: 上电自动跑 38 步体检(AB 停止 -> D2 盘符=U 盘 -> B6=SPK / AE 音量 -> C1/CA/C7 查询基准
       -> A6 试播 -> AA 暂停后 A6 再播 -> DAC/SPK 各播一次 -> AC/AD 换曲
       -> C3 / 不存在的索引 / A6 索引 0 / A0 的"返回码取证"),
       数码管显示"正在试第几步" -> 听到声音就记下数字, 对照 README 第 8 节判读;
       排查完把 WT2003_PROBE_ON_BOOT 改回 0。 */
    wt2003_probe_set_handler(wt2003_probe_show);
    wt2003_probe_start();
#elif (WT2003_NAME_CYCLE_ON_BOOT != 0U)
    /* 按文件名轮播模式(现在用这条): 实测本模块 A6(指定索引播放)收下命令却不出声,
       改用 A7 按文件名播放 —— 每 WT2003_NAME_CYCLE_MS 毫秒播下一个名字
       (名字表见 bsp_config.h 的 WT2003_NAME_CYCLE_LIST, 文件名必须 4 字符且放在
       U 盘根目录), 播后自动查一次 C9/CB; 数码管 + 串口同步显示正在播第几个。
       排查完把 WT2003_NAME_CYCLE_ON_BOOT 改回 0。 */
    (void)wt2003_set_output(WT2003_OUT_SPK);   /* 与体检里"出声那次"一致: 喇叭输出 */
    wt2003_name_set_handler(wt2003_name_show);
    wt2003_name_start();
#elif (WT2003_BOOT_VOICE > 0)
    /* 上电提示音: 固定走串口播放 WT2003_BOOT_VOICE 号音频 */
    (void)wt2003_talk_src((uint16_t)WT2003_BOOT_VOICE, WT2003_SRC_UART);
#endif

~~~~

<!-- ===================== F : Doc/removed_cmd_voice.txt ===================== -->

~~~~
<!-- ======== 涓嬮潰杩欐鏄粠 Src\app_cmd.c 绗?493~794 琛岀Щ闄ょ殑鍘熸枃(鐣欐。) ======== -->
    /*------------------------- 语音模块 ---------------------------*/
    if (bsp_stricmp_eq(tok[0], "VOICE") != 0U)
    {
        uint16_t id;

        if (argc < 2U)
        {
            cmd_reply("ERR VOICE ARGS");
            return;
        }
        id = arg_u16(tok[1], 9999U);
        if (wt2003_talk(id) == 0U)
        {
            cmd_reply("OK VOICE %u %s", (unsigned)id,
                      (wt2003_get_key_of(id) != 0xFFU) ? "KEY" : "UART");
        }
        else
        {
            cmd_reply("ERR VOICE %u", (unsigned)id);
        }
        return;
    }

    if (bsp_stricmp_eq(tok[0], "VKEY") != 0U)
    {
        if (argc < 2U)
        {
            cmd_reply("ERR VKEY ARGS");
            return;
        }
        /* 标准品(WT2003H4-16S)没开放 Key 口功能(需厂家定制) -> 明确回错,
           不要给"命令成功、但一点反应都没有"的假象 */
        if (wt2003_key_available() == 0U)
        {
            cmd_reply("ERR VKEY unavailable (WT2003_KEY_ENABLE=0, use VPLAY)");
            return;
        }
        wt2003_key_pulse((uint8_t)arg_u16(tok[1], 2U));
        cmd_reply("OK VKEY %u", (unsigned)bsp_atoi(tok[1]));
        return;
    }

    /* VPLAY6 <index> : 强制用 A6(指定 U 盘根目录索引播放) —— 手册 4.1.3.4:
       帧 7E 05 A6 <曲目高位> <曲目低位> <校验码> EF(校验码自动算),
       例 索引2 -> 7E 05 A6 00 02 AD EF。和 VPLAY0(A0, SPI Flash)对照,
       确认音频到底在哪块介质上(U 盘用 A0 播会回非 0)。 */
    if (bsp_stricmp_eq(tok[0], "VPLAY6") != 0U)
    {
        uint16_t idx;

        if (argc < 2U)
        {
            cmd_reply("ERR VPLAY6 ARGS (index 0..65535)");
            return;
        }
        idx = arg_u16(tok[1], 0xFFFFU);
        if (wt2003_play_udisk(idx) == 0U)
        {
            cmd_reply("OK VPLAY6 %u (A6 U-disk, see WTRX)", (unsigned)idx);
        }
        else
        {
            cmd_reply("ERR VPLAY6 %u", (unsigned)idx);
        }
        return;
    }

    /* VPLAY0 <index> : 强制用 A0(指定 SPI Flash 根目录索引播放) */
    if (bsp_stricmp_eq(tok[0], "VPLAY0") != 0U)
    {
        uint16_t idx;

        if (argc < 2U)
        {
            cmd_reply("ERR VPLAY0 ARGS (index 0..65535)");
            return;
        }
        idx = arg_u16(tok[1], 0xFFFFU);
        if (wt2003_play_flash(idx) == 0U)
        {
            cmd_reply("OK VPLAY0 %u (A0 flash, see WTRX)", (unsigned)idx);
        }
        else
        {
            cmd_reply("ERR VPLAY0 %u", (unsigned)idx);
        }
        return;
    }

    /* VPLAY <index> : 按索引播放(命令码由 bsp_config.h 的 WT2003_PLAY_USE_UDISK 选:
       1 = A6 播 U 盘根目录索引【默认】, 0 = A0 播 SPI Flash; 校验码自动算),
       方便"0,1,2,3… 逐个索引扫一遍"确认模块里文件的实际索引号
       (索引顺序是出厂/上位机设定的, 不一定等于你预期的编号)。
       模块回帧看 ESP32 串口的 WTRX/WTRXINFO 行: 数据字节 00 = 已接受, 非 0 = 没播
       -> 先查文件数/索引, 见 README 8.2。
       想显式指定介质: VPLAY6 <idx>(A6) / VPLAY0 <idx>(A0)。 */
    if (bsp_stricmp_eq(tok[0], "VPLAY") != 0U)
    {
        uint16_t idx;

        if (argc < 2U)
        {
            cmd_reply("ERR VPLAY ARGS (index 0..65535)");
            return;
        }
        idx = arg_u16(tok[1], 0xFFFFU);
        if (wt2003_play_index(idx) == 0U)
        {
#if (WT2003_PLAY_USE_UDISK != 0U)
            cmd_reply("OK VPLAY %u (A6 U-disk, see WTRX)", (unsigned)idx);
#else
            cmd_reply("OK VPLAY %u (A0 flash, see WTRX)", (unsigned)idx);
#endif
        }
        else
        {
            cmd_reply("ERR VPLAY %u", (unsigned)idx);
        }
        return;
    }

    if (bsp_stricmp_eq(tok[0], "VOL") != 0U)
    {
        if (argc < 2U)
        {
            cmd_reply("ERR VOL ARGS");
            return;
        }
        (void)wt2003_set_volume((uint8_t)arg_u16(tok[1], 31U));
        cmd_reply("OK VOL %u", (unsigned)wt2003_get_volume());
        return;
    }

    /* VOUT 0 = SPK(内部功放/喇叭), 1 = DAC 输出 (B6 命令) */
    if (bsp_stricmp_eq(tok[0], "VOUT") != 0U)
    {
        if (argc < 2U)
        {
            cmd_reply("ERR VOUT ARGS (0=SPK 1=DAC)");
            return;
        }
        if (arg_u16(tok[1], 1U) != 0U)
        {
            (void)wt2003_set_output(WT2003_OUT_DAC);
            cmd_reply("OK VOUT DAC");
        }
        else
        {
            (void)wt2003_set_output(WT2003_OUT_SPK);
            cmd_reply("OK VOUT SPK");
        }
        return;
    }

    /* VQRY VER|VOL|ST|FILES|CUR : 发查询命令(C0/C1/C2/C3/C9), 应答看 WTRX */
    if (bsp_stricmp_eq(tok[0], "VQRY") != 0U)
    {
        if (argc < 2U)
        {
            cmd_reply("ERR VQRY ARGS (VER/VOL/ST/FILES/CUR)");
            return;
        }
        if (bsp_stricmp_eq(tok[1], "VER") != 0U)
        {
            (void)wt2003_query_version();
        }
        else if (bsp_stricmp_eq(tok[1], "VOL") != 0U)
        {
            (void)wt2003_query_volume();
        }
        else if (bsp_stricmp_eq(tok[1], "ST") != 0U)
        {
            (void)wt2003_query_status();
        }
        else if (bsp_stricmp_eq(tok[1], "FILES") != 0U)
        {
            (void)wt2003_query_file_num();
        }
        else if (bsp_stricmp_eq(tok[1], "CUR") != 0U)
        {
            (void)wt2003_query_cur_file();
        }
        else
        {
            cmd_reply("ERR VQRY ARGS (VER/VOL/ST/FILES/CUR)");
            return;
        }
        cmd_reply("OK VQRY %s (see WTRX)", tok[1]);
        return;
    }

    /* VCHECK : 一键体检 —— 依次发 8 条查询命令(C0 版本 / C1 音量 / C2 状态 /
       C3 文件数 / CA 外设连接 / C7 U 盘文件数 / C9 当前文件 / CB 歌曲名),
       注: 手册写 C3 是 SPI-Flash 口径, 但实测本模块 C3 == C7 同为 1 字节,
           别拿 C3 判介质, 看音频在哪块盘用 A0/A6 试听或看 CA/C7(见 README 8.9)。
       每条间隔 120ms 等模块回帧。
       芯片返回的原始字节 + 解析会通过 USART1 直接打到 ESP32:
           WTRXRAW   模块回帧的原始字节(7E 长度 命令 数据 校验码 EF)
           WTRX      命令码 + 数据区
           WTRXINFO  人话解析: volume= / flash_files= / conn= / udisk_files= /
                     cur_file= / name= / status=
       本项目音频在 U 盘 -> 重点看 udisk_files=(是 0 就没认到盘)。注意:
       查询命令回的是"数据"不是返回码; 写命令的返回码是 00=OK / 01=FAIL / 02=EMP(无此文件),
       而本模块实测 A6/D2/C7 会回手册没定义的 0x05 —— 那几轮音频照样出声, 别当成"没播"(见 README 8.7)。 */
    if (bsp_stricmp_eq(tok[0], "VCHECK") != 0U)
    {
        (void)wt2003_query_version();
        bsp_delay_ms(120U);
        (void)wt2003_query_volume();
        bsp_delay_ms(120U);
        (void)wt2003_query_status();
        bsp_delay_ms(120U);
        (void)wt2003_query_file_num();          /* C3: SPI-Flash 文件数(本工程恒为 0) */
        bsp_delay_ms(120U);
        (void)wt2003_query_conn();              /* CA: 外设连接状态(重点看 U 盘位 bit2) */
        bsp_delay_ms(120U);
        (void)wt2003_query_udisk_num();         /* C7: U 盘内文件总数 <== 本工程看这条 */
        bsp_delay_ms(120U);
        (void)wt2003_query_cur_file();          /* C9: 当前播放文件 */
        bsp_delay_ms(120U);
        (void)wt2003_query_cur_name();          /* CB: 当前播放歌曲名 */
        cmd_reply("OK VCHECK (see WTRX/WTRXINFO)");
        return;
    }

    if ((bsp_stricmp_eq(tok[0], "VSTOP") != 0U) || (bsp_stricmp_eq(tok[0], "VPAUSE") != 0U)
        || (bsp_stricmp_eq(tok[0], "VNEXT") != 0U) || (bsp_stricmp_eq(tok[0], "VPREV") != 0U))
    {
        if (bsp_stricmp_eq(tok[0], "VSTOP") != 0U)
        {
            (void)wt2003_stop();
        }
        else if (bsp_stricmp_eq(tok[0], "VPAUSE") != 0U)
        {
            (void)wt2003_pause();
        }
        else if (bsp_stricmp_eq(tok[0], "VNEXT") != 0U)
        {
            (void)wt2003_play_next();
        }
        else
        {
            (void)wt2003_play_prev();
        }
        cmd_reply("OK %s", tok[0]);
        return;
    }

    /* VNAME : 按文件名播放/轮播(A7 播"U 盘根目录里 4 字符文件名"的音频)。
       为什么用它: 实测本模块 A6(指定 U 盘索引播放)收下命令却不出声(回 0x05),
       而 A7 按文件名播放能出声(见 README 8.9)。名字列表在 bsp_config.h 的
       WT2003_NAME_CYCLE_LIST, 例如 { "T001","T002" } 对应 U 盘上的 T001.mp3 / T002.mp3。
         VNAME            : 列出配置里的文件名(第几个 = 第 n 项)
         VNAME <n>        : 立刻播第 n 个(1..N), 数码管显示 n, 串口打 NAME n/N "T00n"
         VNAMEON/VNAMEOFF : 开/关"每 WT2003_NAME_CYCLE_MS 毫秒播下一个"的自动轮播 */
    if (bsp_stricmp_eq(tok[0], "VNAME") != 0U)
    {
        if (argc < 2U)
        {
            uint8_t i;
            uint8_t total = wt2003_name_count();

            cmd_reply("OK VNAME n=%u every=%ums (A7 by file name)", (unsigned)total,
                      (unsigned)WT2003_NAME_CYCLE_MS);
            for (i = 1U; i <= total; i++)
            {
                cmd_reply("NAME %u \"%s\"", (unsigned)i, wt2003_name_get(i));
            }
            return;
        }

        {
            uint16_t n = arg_u16(tok[1], 0U);

            if ((n == 0U) || (n > (uint16_t)wt2003_name_count())
                || (wt2003_name_fire((uint8_t)n) != 0U))
            {
                cmd_reply("ERR VNAME %u (1..%u)", (unsigned)n,
                          (unsigned)wt2003_name_count());
                return;
            }
            cmd_reply("OK VNAME %u = \"%s\" (A7 U-disk by name, see WTRX)",
                      (unsigned)n, wt2003_name_get((uint8_t)n));
        }
        return;
    }

    if ((bsp_stricmp_eq(tok[0], "VNAMEON") != 0U) || (bsp_stricmp_eq(tok[0], "VNAMEOFF") != 0U))
    {
        if (bsp_stricmp_eq(tok[0], "VNAMEON") != 0U)
        {
            wt2003_name_start();
            cmd_reply("OK VNAMEON %u files, %u ms each (A7 by file name)",
                      (unsigned)wt2003_name_count(), (unsigned)WT2003_NAME_CYCLE_MS);
        }
        else
        {
            wt2003_name_stop();
            cmd_reply("OK VNAMEOFF (VNAME <n> still works)");
        }
        return;
    }

~~~~

<!-- ===================== G : Doc/removed_cmd_retire.txt ===================== -->

~~~~
<!-- ======== 涓嬮潰杩欐鏄粠 Src\app_cmd.c 绗?525~597 琛岀Щ闄ょ殑鍘熸枃(鐣欐。) ======== -->
    /*------------------------- 语音模块调试 -----------------------*/
    /*免烧录反复试: 用这几条命令手工复现自检序列里的某一步。
       WTPROBE      : 不带参数 = 重新开始整轮(38 步)自检序列
       WTPROBE <n>  : 立刻单独发第 n 步 n=1..wt2003_probe_count()(提示文字见
                      wt2003_probe_cfg_hint(), 例: 6 = CA 查外设(有没有 U 盘), 7 = C7 查 U 盘文件数,
                      10 = A6 播 U 盘索引1, 25 = AC 下一曲, 29 = A6 播索引2, 31~38 = 返回码取证)
       WTSTOP       : 停止自动自检
       WTST         : 查询状态(模块回帧字节数 / 已发命令帧数 / 是否在自检) */
    /* WTRAW <hex...> : 把任意字节序列原样发给模块(不重烧就能试手册里的任意帧)。
       注: 这条命令已经回归到现行固件, 名字改成了 VRAW(行为/用法完全一样, 见 README 第 4 节
           与 app_cmd.c 的 VRAW 分支); 下面这段是精简前的原文, 只作留档。
       例: WTRAW 7E05A60001ACEF        (A6 播 U 盘索引 1；长度含自身 + 累加和)
           WTRAW 7E 05 A6 00 01 AC EF  (空格分隔, 也接受 0x7E / 逗号 / 冒号; A6 = 播 U 盘索引 1)
       发完看 ESP32 串口的 WTRX 行(WT2003_RX_TRACE=1 时)并听喇叭; 详见 README 第 8 节。 */
    if (bsp_stricmp_eq(tok[0], "WTRAW") != 0U)
    {
        uint8_t frame[WT2003_RX_FRAME_MAX];
        char    hex[(2U * WT2003_RX_FRAME_MAX) + 1U];
        uint8_t len = 0U;
        uint8_t i;

        for (i = 1U; (i < argc) && (len < (uint8_t)sizeof(frame)); i++)
        {
            len = hex_append(tok[i], frame, (uint8_t)sizeof(frame), len);
        }

        if (len == 0U)
        {
            cmd_reply("ERR WTRAW HEX (e.g. WTRAW 7E05A00001A6EF)");
            return;
        }

        hex_encode(frame, len, hex);
        if (wt2003_send_raw(frame, len) != 0U)
        {
            cmd_reply("ERR WTRAW TX %s", hex);
            return;
        }
        cmd_reply("OK WTRAW %s (%u bytes)", hex, (unsigned)len);
        return;
    }

    if (bsp_stricmp_eq(tok[0], "WTPROBE") != 0U)
    {
        if (argc < 2U)
        {
            wt2003_probe_start();
            cmd_reply("OK WTPROBE START n=%u", (unsigned)wt2003_probe_count());
            return;
        }

        if (wt2003_probe_fire(arg_u8(tok[1])) != 0U)
        {
            cmd_reply("ERR WTPROBE RANGE 1..%u", (unsigned)wt2003_probe_count());
            return;
        }
        cmd_reply("OK WTPROBE %u %s", (unsigned)arg_u8(tok[1]),
                  wt2003_probe_cfg_hint(arg_u8(tok[1])));
        return;
    }

    if (bsp_stricmp_eq(tok[0], "WTSTOP") != 0U)
    {
        wt2003_probe_stop();
        cmd_reply("OK WTSTOP");
        return;
    }

    if (bsp_stricmp_eq(tok[0], "WTST") != 0U)
    {
        cmd_reply("WTST probe=%u rx=%lu cmd=%lu", (unsigned)wt2003_probe_is_running(),
                  (unsigned long)wt2003_rx_total(), (unsigned long)wt2003_cmd_count());
        return;
    }

~~~~

<!-- ===================== H : Doc/removed_cmd_hex.txt ===================== -->

~~~~
<!-- ======== 涓嬮潰杩欐鏄粠 Src\app_cmd.c 绗?77~138 琛岀Щ闄ょ殑鍘熸枃(鐣欐。) ======== -->
/*---------------------------------------------------------------------------*/
/** 十六进制串 -> 字节流(追加式): 每两个十六进制字符合成一个字节,
 *  其余字符(空格 / "0x" 的 x / 逗号 / 冒号)当分隔符, 落单的半字节忽略。
 *  例: "7E0441" / "7E 04 41" / "0x7E,0x04" 都能解析。
 *  @return 追加后的总字节数(<= out_max) */
static uint8_t hex_append(const char *s, uint8_t *out, uint8_t out_max, uint8_t len)
{
    uint8_t nib = 0xFFU;        /* 高 4 位暂存; 0xFF = 还没有半个字节 */

    while ((*s != '\0') && (len < out_max))
    {
        char    c = *s++;
        uint8_t v;

        if ((c >= '0') && (c <= '9'))
        {
            v = (uint8_t)(c - '0');
        }
        else if ((c >= 'a') && (c <= 'f'))
        {
            v = (uint8_t)(c - 'a' + 10);
        }
        else if ((c >= 'A') && (c <= 'F'))
        {
            v = (uint8_t)(c - 'A' + 10);
        }
        else
        {
            nib = 0xFFU;        /* 分隔符: 断开重来 */
            continue;
        }

        if (nib == 0xFFU)
        {
            nib = v;
        }
        else
        {
            out[len] = (uint8_t)((uint8_t)(nib << 4) | v);
            len++;
            nib = 0xFFU;
        }
    }
    return len;
}

/*---------------------------------------------------------------------------*/
static const char s_hex_map[17] = "0123456789ABCDEF";

/** 字节流 -> 大写十六进制字符串(buf 至少 2*len+1 字节) */
static void hex_encode(const uint8_t *in, uint8_t len, char *buf)
{
    uint8_t i;

    for (i = 0U; i < len; i++)
    {
        buf[2U * i]        = s_hex_map[(in[i] >> 4) & 0x0FU];
        buf[(2U * i) + 1U] = s_hex_map[in[i] & 0x0FU];
    }
    buf[2U * len] = '\0';
}

~~~~

<!-- ===================== I : Doc/removed_cmd_shutdown.txt ===================== -->

~~~~
<!-- ======== 涓嬮潰杩欐鏄粠 Src\app_cmd.c 绗?177~177 琛岀Щ闄ょ殑鍘熸枃(鐣欐。) ======== -->
    (void)wt2003_talk(10U);           /* 例: 编号 10 = "正在关机" */

~~~~

<!-- ===================== J : Doc/removed_task_voice.txt ===================== -->

~~~~
<!-- ======== 涓嬮潰杩欐鏄粠 Src\app_task.c 绗?92~110 琛岀Щ闄ょ殑鍘熸枃(鐣欐。) ======== -->
static void app_task_voice(void const *arg)
{
    uint32_t req;

    (void)arg;

    /* 打开"队列模式": 之后任何任务调用 wt2003_talk() 只是投递请求(非阻塞),
       真正的 Key 脉冲/串口发送由本任务执行, 于是模块只有一个"主人"。 */
    wt2003_use_task(1U);

    for (;;)
    {
        if (wt2003_take_request(&req, APP_TASK_VOICE_PERIOD_MS) != 0U)
        {
            (void)wt2003_exec_request(req);   /* Key 口会阻塞一个脉冲宽度(约 100ms) */
        }
        wt2003_process();       /* 解析模块返回帧 + 兜底释放 Key 脉冲 */
    }
}

~~~~

<!-- ===================== K : Doc/removed_cmdh_voice.txt ===================== -->

~~~~
<!-- ======== 涓嬮潰杩欐鏄粠 Inc\app_cmd.h 绗?17~35 琛岀Щ闄ょ殑鍘熸枃(鐣欐。) ======== -->
  *   VOICE <id>                           -> OK VOICE
  *   VKEY <0..2>                          -> OK VKEY   (K1~K3 脉冲; 本硬件标准品
  *                                                    未开放 Key 口 -> ERR)
  *   VPLAY <index>                        -> OK VPLAY  (按默认介质播放: A6 U 盘【默认】/
  *                                                    A0 Flash, 由 WT2003_PLAY_USE_UDISK 选)
  *   VPLAY6 <index> | VPLAY0 <index>      -> OK VPLAY6 / OK VPLAY0  (强制 A6 U 盘 / A0 Flash)
  *   VCHECK                               -> OK VCHECK (一键体检: 连发
  *                                        C0/C1/C2/C3/CA/C7/C9/CB,
  *                                        回帧+解析见 WTRX/WTRXINFO;
  *                                        重点看 udisk_files=;
  *                                        写命令返回码 00=OK/01=FAIL/02=EMP,
  *                                        实测 A6 回 05 也照样出声, 别当失败)
  *   VOL <0..30>                          -> OK VOL
  *   VSTOP | VNEXT | VPREV | VPAUSE       -> OK ...
  *   VNAME [n]                            -> OK VNAME (按文件名播放 A7: 不带宽参 = 列出名字表;
  *                                        VNAME <n> = 立刻播第 n 个; 名字表见 bsp_config.h 的
  *                                        WT2003_NAME_CYCLE_LIST, 文件名必须 4 字符放在 U 盘根目录。
  *                                        实测本模块 A6 按索引播不出声, 故改用 A7 按文件名)
  *   VNAMEON | VNAMEOFF                   -> OK VNAMEON / OK VNAMEOFF (开/关每 4 秒播下一个的轮播)

~~~~
