kaiserShao/LEDPlay/SW/stp/按键微动底座.STEP

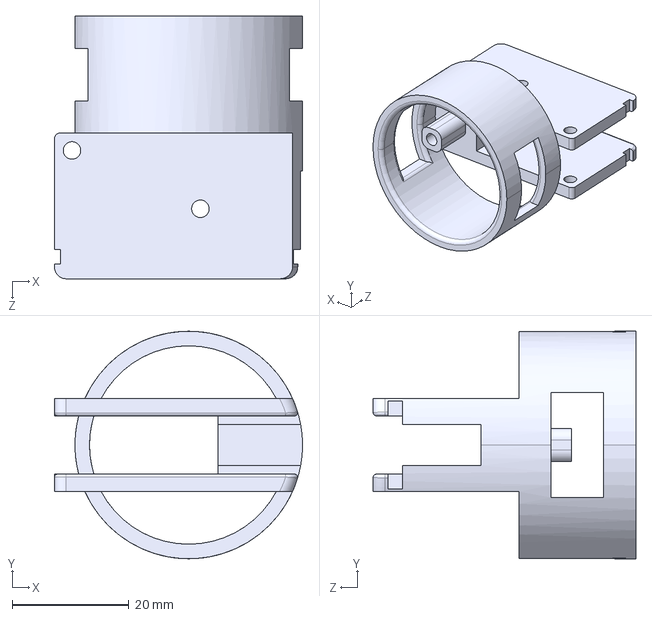
[picture p2: CAD file, 2026-10-15]
SW/stp/按键微动底座.STEP
42.5 x 39.0 x 45.0 mm
