kaiserShao/LEDPlay/SW/stp/底座.STEP

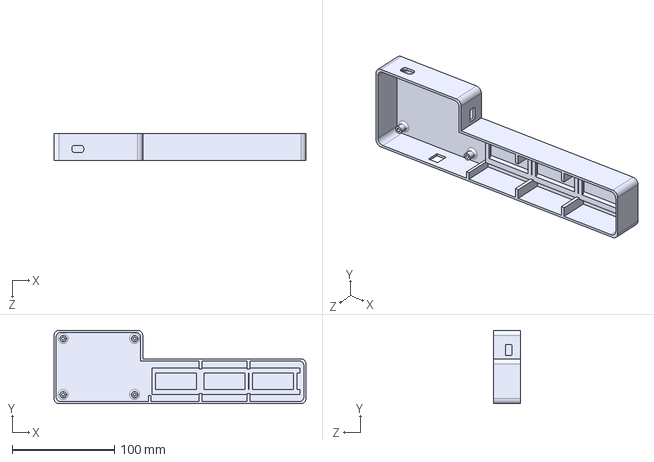
[picture p3: CAD file, 2026-10-15]
SW/stp/底座.STEP
247.0 x 72.0 x 26.5 mm
