kaiserShao/LEDPlay/SW/按键灯.SLDPRT

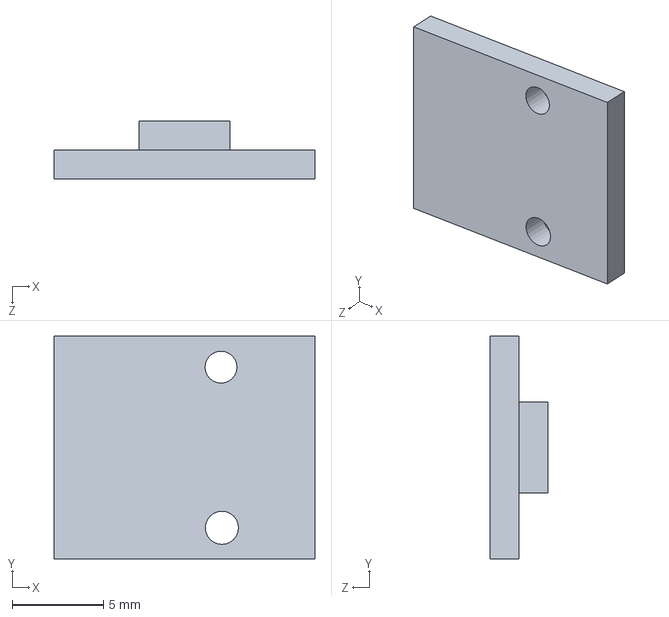
[picture p4: CAD file, 2026-10-15]
SW/按键灯.SLDPRT
14.3 x 12.2 x 3.20 mm
