kaiserShao/LEDPlay/SW/主板.SLDPRT

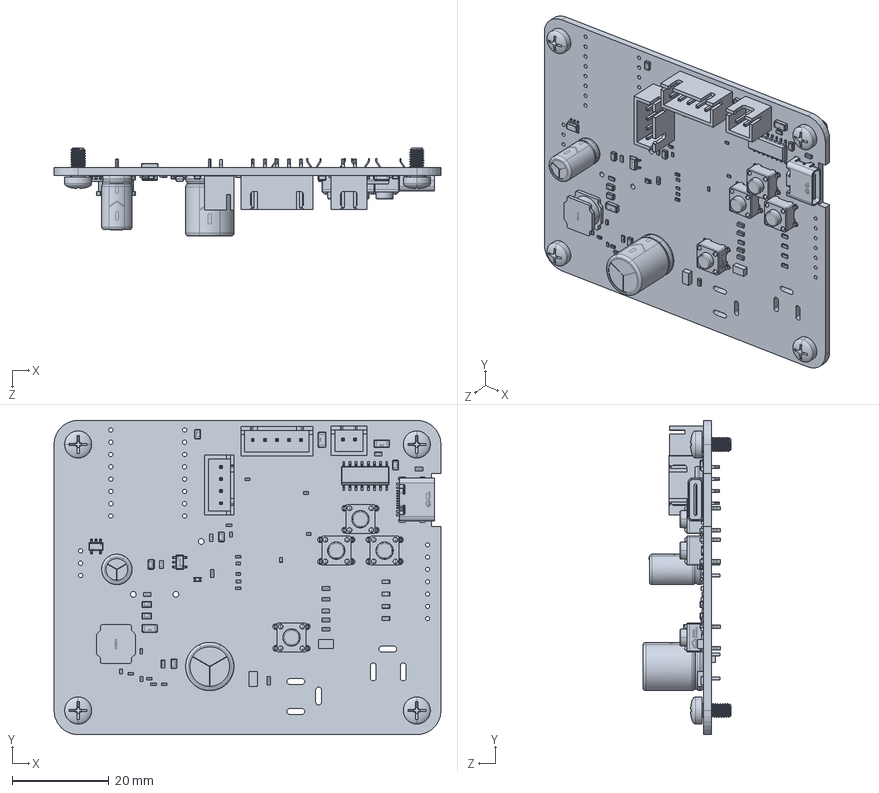
[picture p5: CAD file, 2026-10-15]
SW/主板.SLDPRT
80.0 x 65.0 x 18.2 mm
