kaiserShao/LEDPlay/SW/stp/灯座.STEP

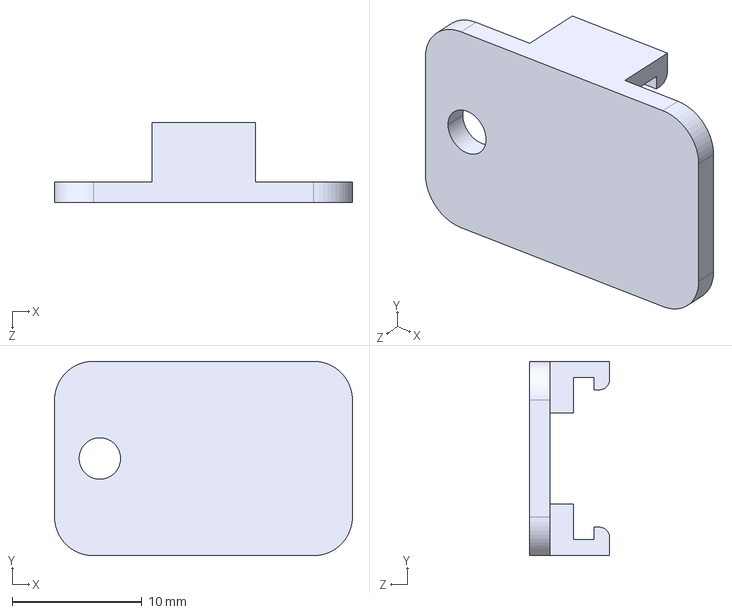
[picture p6: CAD file, 2026-10-15]
SW/stp/灯座.STEP
23.0 x 15.0 x 6.20 mm
