kaiserShao/LEDPlay/SW/stp/消消乐上盖.STEP

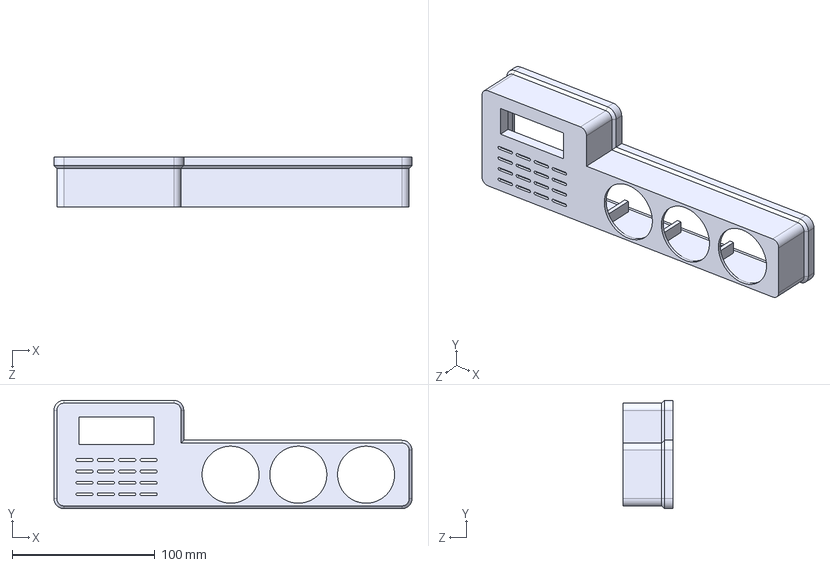
[picture p7: CAD file, 2026-10-15]
SW/stp/消消乐上盖.STEP
251.0 x 76.0 x 35.0 mm
