kaiserShao/LEDPlay/SW/stp/带灯按键帽.STEP

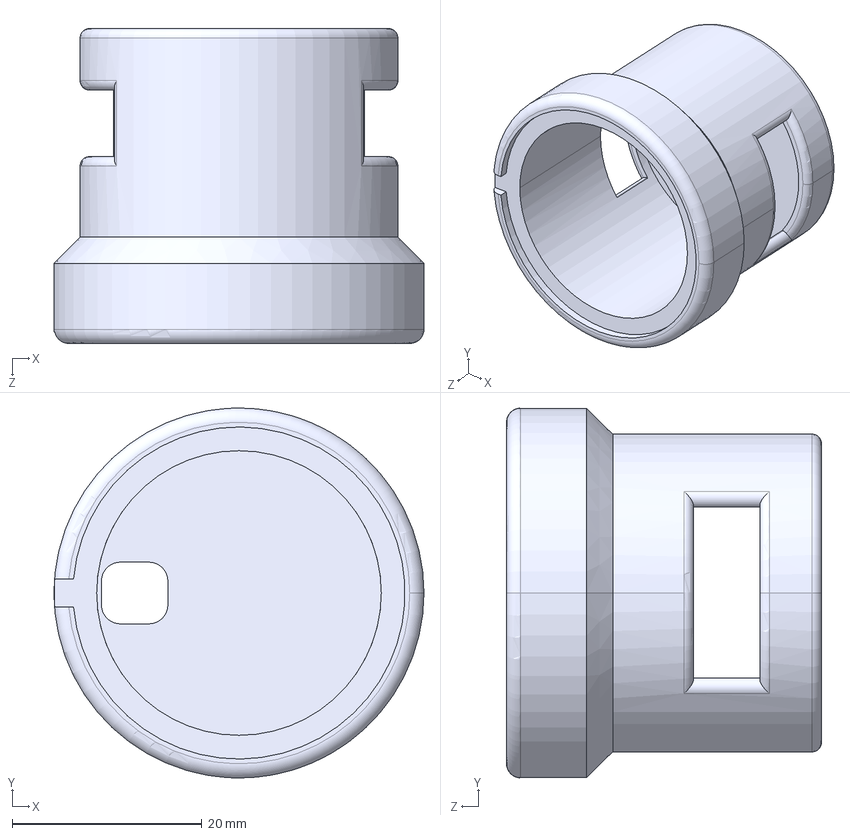
[picture p8: CAD file, 2026-10-15]
SW/stp/带灯按键帽.STEP
39.0 x 39.0 x 33.2 mm
