kaiserShao/LEDPlay/SW/stp/销钉.STEP

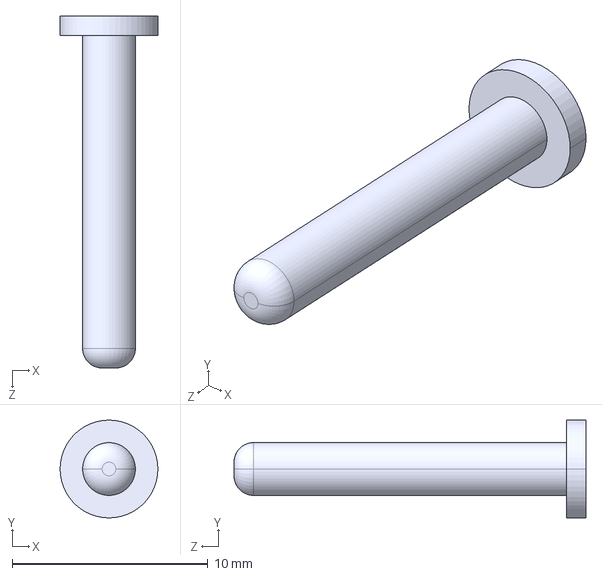
[picture p9: CAD file, 2026-10-15]
SW/stp/销钉.STEP
5.00 x 5.00 x 18.0 mm
