kaiserShao/LEDPlay/SW/消消乐外壳.SLDASM

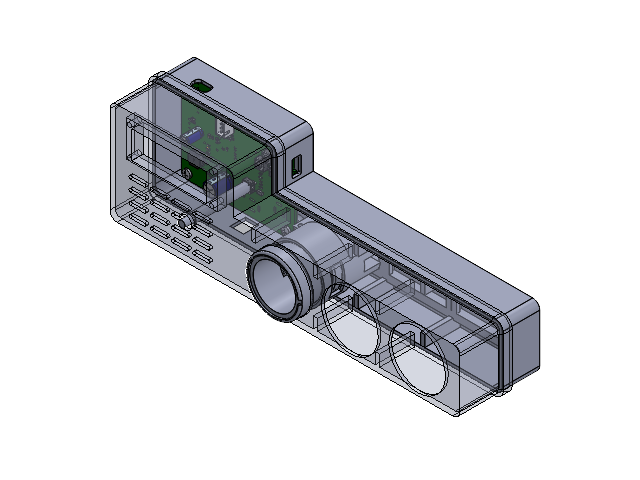
[picture p10: CAD file, 2026-10-15]
SW/消消乐外壳.SLDASM
主板
底座
按键微动底座
按键灯
带灯按键帽
消消乐上盖
灯座
电源按键
