kaiserShao/LEDPlay/(list of files, cad)

Other CAD files:
SW/带灯按键帽.SLDPRT
SW/底座.SLDPRT
SW/按键微动底座.SLDPRT
SW/消消乐上盖.SLDPRT
SW/灯座.SLDPRT
SW/电源按键.SLDPRT
SW/销钉.SLDPRT
