kaiserShao/LEDPlay/(list of files, drawings)

Other design files:
灯带消消乐/灯带消消乐.PrjPcb
灯带消消乐/灯带消消乐.SchDoc
灯带消消乐/灯带消消乐V1.0.PcbDoc
